LCAV/crazyflie-audio/doc/spectrum_warping.JPG

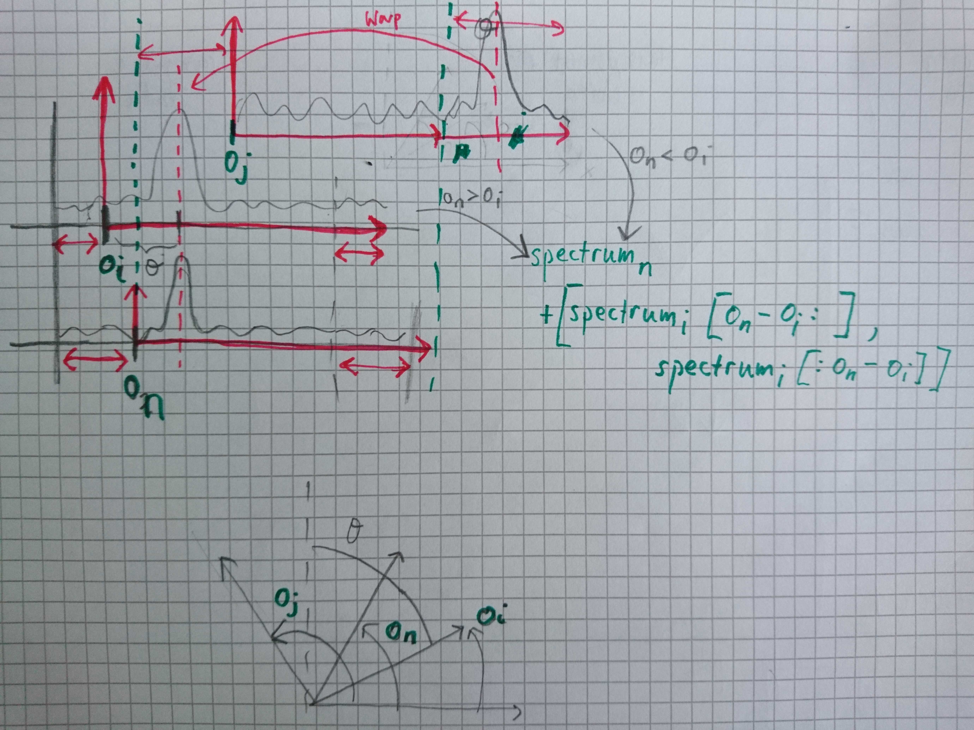
doc/spectrum_warping.JPG
