LCAV/crazyflie-audio/doc/PID tuning the crazyflie.pdf

## PID tuning the crazyflie

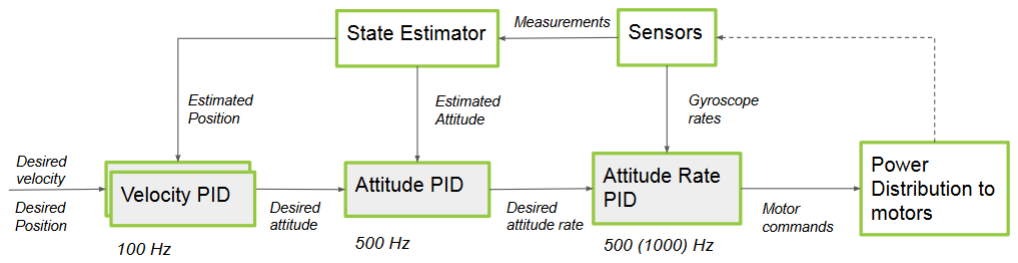
[picture p2: figure]

### Preliminary steps

static trigger_t sitAwFFAccWZ;

static trigger_t sitAwARAccZ;

static trigger_t sitAwTuAcc;

should be commented to avoid compilation errors.

static RPYType stabilizationModeRoll = ANGLE; static RPYType stabilizationModePitch = ANGLE;

should become

static RPYType stabilizationModeRoll = RATE; static RPYType stabilizationModePitch = RATE;

Once all of this is done the modified firmware is uploaded to the crazyflie.

Then we connect to the crazyflie using the client. In the “parameter” tab we can access and change directly the PID gains. Parameter names are pid_rate and pid_attitude. A gaming controller is used to control the crazyflie.

### Tuning the rate PID

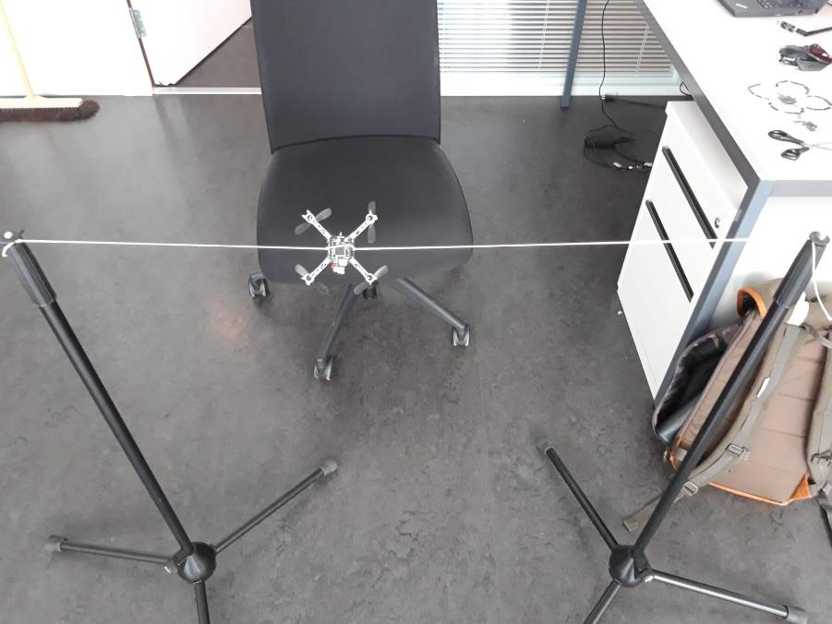
[picture p3: figure]

### Tuning the attitude PID

### Final step
