LCAV/crazyflie-audio/doc/pwm_tuning_control.xlsx

index | Target | Expected error | Measured frequency | Actual error
0 | 3000 | 0 | 3003 | 3
1 | 3125 | 0 | 3133.8 | 8.8
2 | 3250 | 45 | 3260.3 | 10.3
3 | 3375 | 36 | 3381 | 6
4 | 3500 | 0 | 3510.2 | 10.2
5 | 3625 | 18 | 3637.6 | 12.6
6 | 3750 | 0 | 3762.7 | 12.7
7 | 3875 | 19 | 3885.6 | 10.6
8 | 4000 | 0 | 4012.7 | 12.7
9 | 4125 | 31 | 4137.8 | 12.8
10 | 4250 | 36 | 4257.7 | 7.7
11 | 4375 | 0 | 4388.8 | 13.8
12 | 4500 | 36 | 4510.4 | 10.4
13 | 4625 | 9 | 4639.4 | 14.4
14 | 4750 | 125 | 4767.1 | 17.1
15 | 4875 | 45 | 4889.8 | 14.8
