LCAV/crazyflie-audio/hardware/audio_shield_prod/generated/audio_shield-B_Cu.pdf

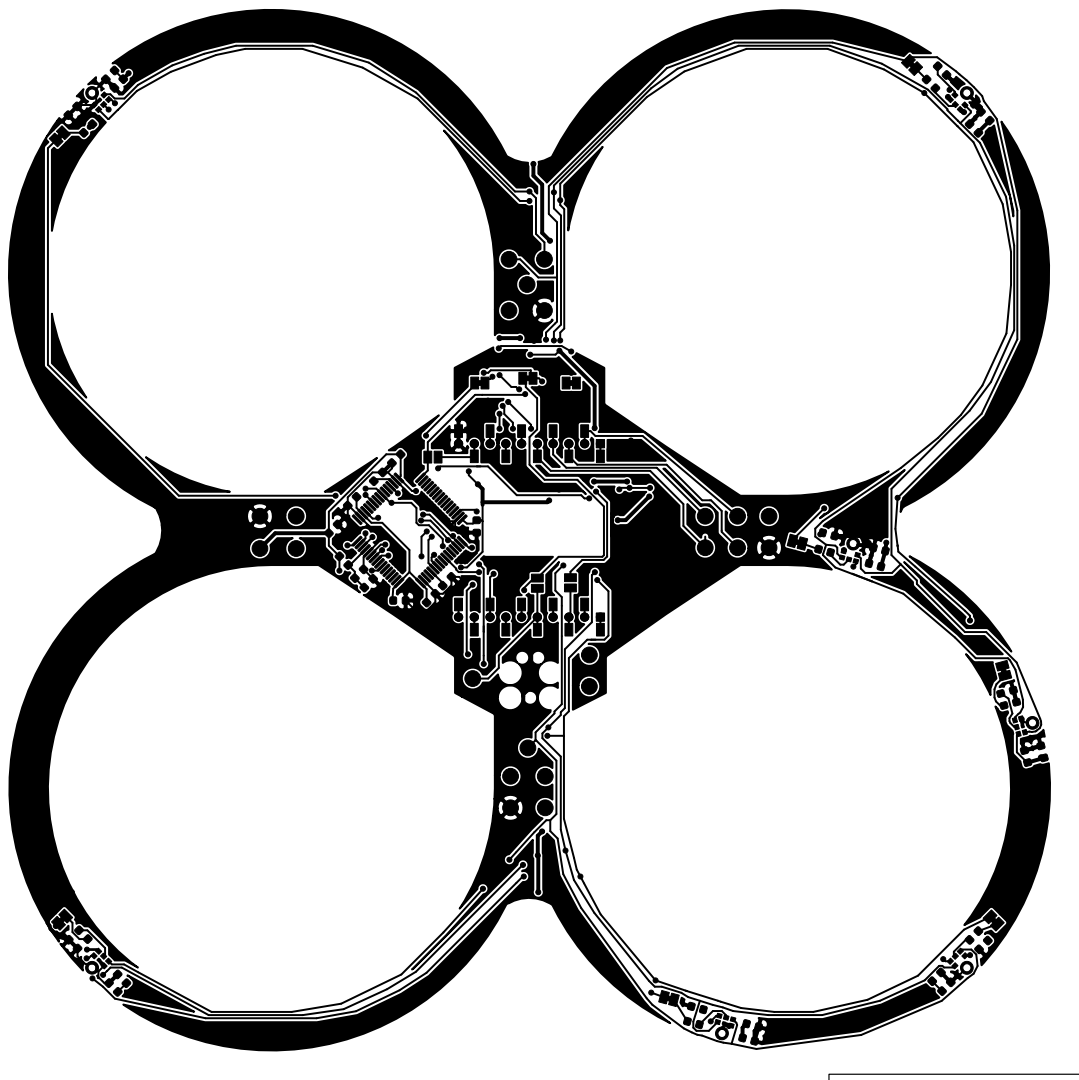
[picture p4: page 1]

Licensed under CC-BY 4.0
File: audio_shield.kicad_pcb Sheet: Bitcraze AB

Id: 1/1 Title: Crazyflie 2.0 expansion template
