LCAV/crazyflie-audio/hardware/audio_shield_V3/audio_shield.kicad_pcb

## KiCad design hardware/audio_shield_V3/audio_shield.kicad_pcb (2021-10-05)

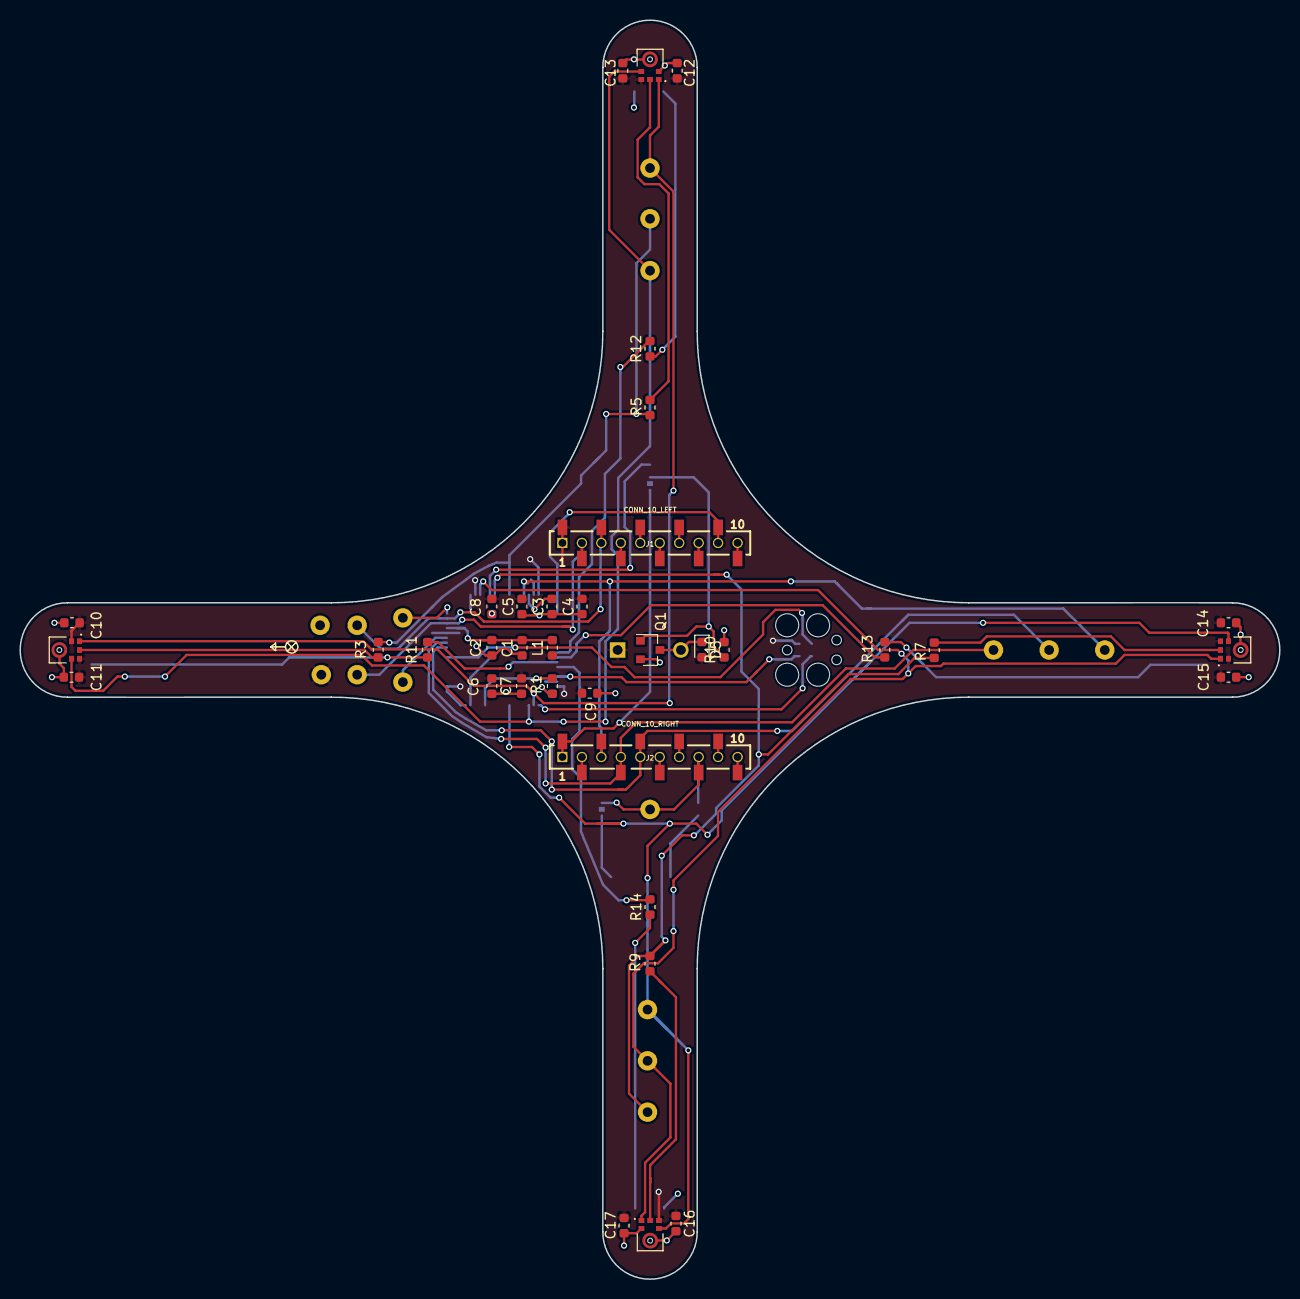
[picture p5: board hardware/audio_shield_V3/audio_shield.kicad_pcb from above]

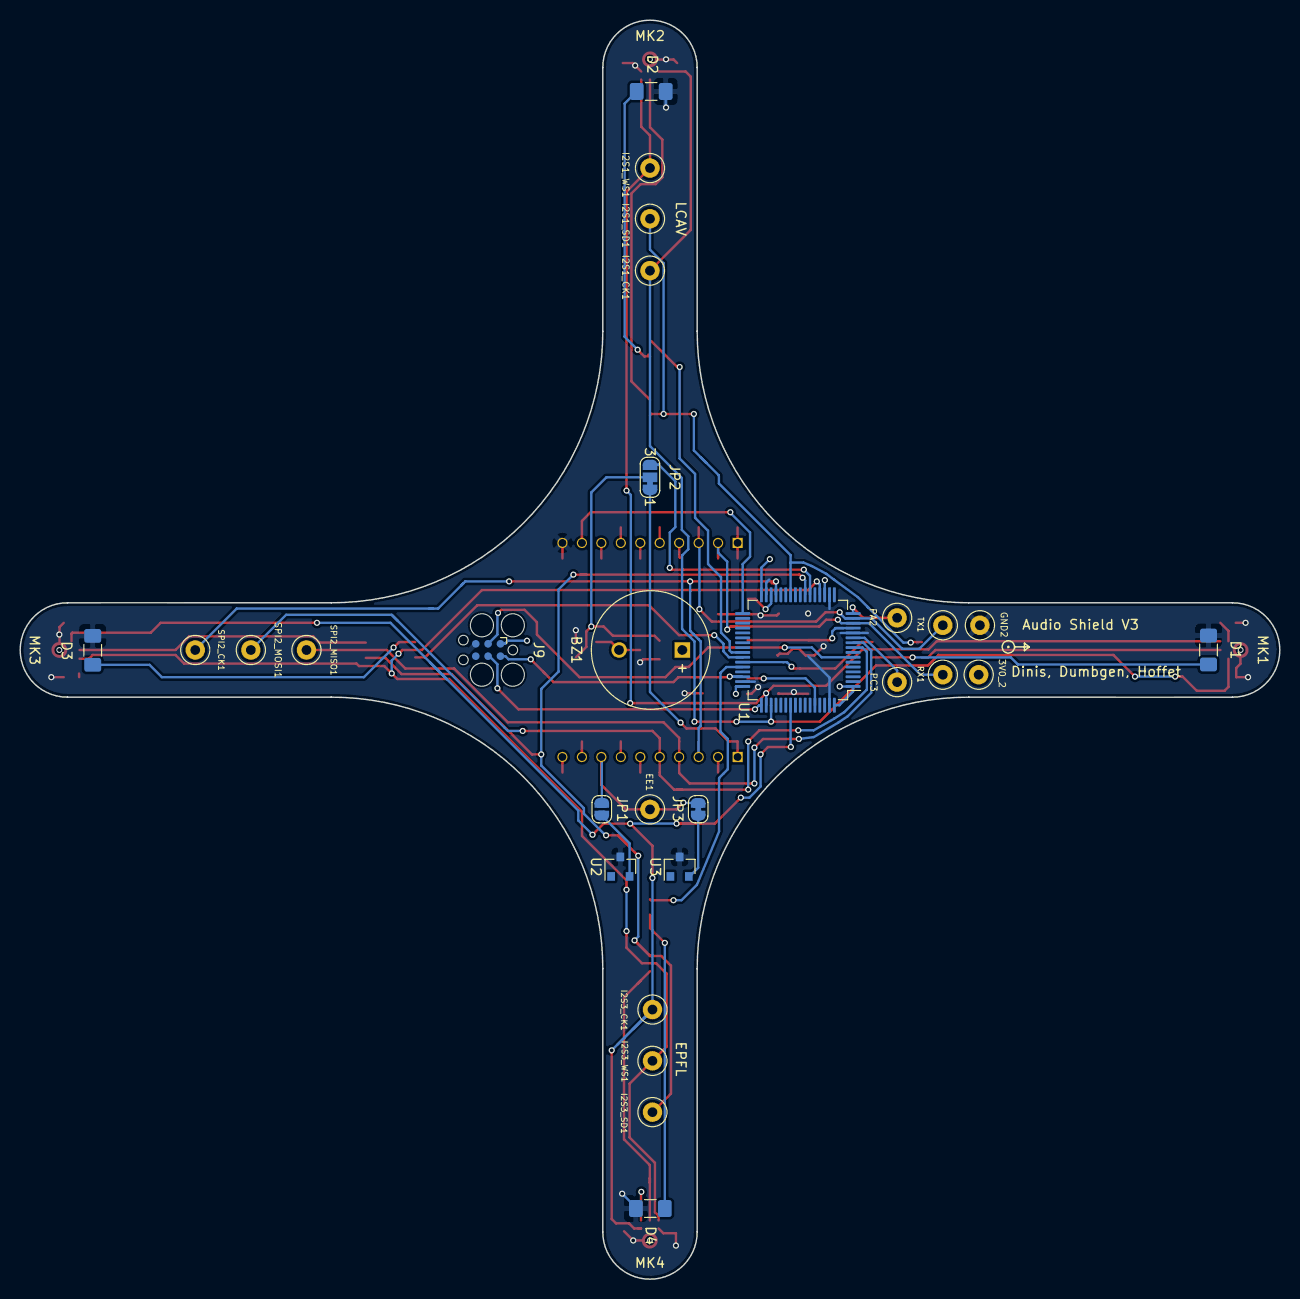
[picture p6: board hardware/audio_shield_V3/audio_shield.kicad_pcb from below]

Board: 2 copper layers, 129.5 x 129.4 mm, 64 parts (28 on the bottom side), 41 nets.

Parts:
3V0_2: TestPoint; TestPoint_Loop_D2.50mm_Drill1.0mm_LowProfile
BZ1: KXG1201B; MagneticBuzzer_ProSignal_ABT-410-RC
C1, C5, C6, C7, C8, C9, C11, C13, C15, C17: 100n; C_0603_1608Metric
C2: 1u; C_0603_1608Metric
C3, C4: 4.7u; C_0603_1608Metric
C10, C12, C14, C16: 220p; C_0603_1608Metric
D1: LED_G; R_1206_3216Metric_Pad1.42x1.75mm_HandSolder
D2, D3, D4: LED_R; R_1206_3216Metric_Pad1.42x1.75mm_HandSolder
D5: DIODE; D_0603_1608Metric
EE1: TestPoint; TestPoint_Loop_D2.50mm_Drill1.0mm_LowProfile
GND2: TestPoint; TestPoint_Loop_D2.50mm_Drill1.0mm_LowProfile
I2S1_CK1, I2S1_SD1, I2S1_WS1, I2S3_CK1, I2S3_SD1, I2S3_WS1: TestPoint; TestPoint_Loop_D2.50mm_Drill1.0mm_LowProfile
J1: CONN_10_LEFT; BF090-10-X-B2
J2: CONN_10_RIGHT; BF090-10-X-B2
J9: SWD_TC2030; Tag-Connect_TC2030-IDC-FP_2x03_P1.27mm_Vertical
JP1: Jumper_2_Open; SolderJumper-2_P1.3mm_Open_RoundedPad1.0x1.5mm
JP2: Jumper_3_Bridged12; SolderJumper-3_P1.3mm_Bridged12_RoundedPad1.0x1.5mm_NumberL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
JP3: Jumper_2_Bridged; SolderJumper-2_P1.3mm_Bridged_RoundedPad1.0x1.5mm
L1: 2.2uH/15mA; L_0603_1608Metric
MK1, MK2, MK3, MK4: SPH0645LM4H-B; MIC_SPH0645LM4H-B
PA2: TestPoint; TestPoint_Loop_D2.50mm_Drill1.0mm_LowProfile
PC3: TestPoint; TestPoint_Loop_D2.50mm_Drill1.0mm_LowProfile
Q1: BS170F; SOT-23
R1, R10: 10k; R_0603_1608Metric
R3, R5, R7, R9, R11, R12, R13, R14: 68; R_0603_1608Metric
RX1: TestPoint; TestPoint_Loop_D2.50mm_Drill1.0mm_LowProfile
SPI2_CK1, SPI2_MISO1, SPI2_MOSI1: TestPoint; TestPoint_Loop_D2.50mm_Drill1.0mm_LowProfile
TX1: TestPoint; TestPoint_Loop_D2.50mm_Drill1.0mm_LowProfile
U1: STM32F446RETx; LQFP-64_10x10mm_P0.5mm
U2, U3: DS2401Z; SOT-23

Connections:
+3V0: 3V0_2.1, BZ1.1, C4.1, C5.1, C6.1, C7.1, C8.1, C9.1, C10.2, C11.2, C12.2, C13.2, C14.2, C15.2, C16.2, C17.2, D5.2, J1.1, J9.1, L1.2, MK1.2, MK1.5, MK2.5, MK3.2, MK3.5, MK4.5, U1.1, U1.19, U1.32, U1.48, U1.64
/AD_Buzzer: JP2.3, U1.22
/CF_Buzzer: J2.1, JP2.1
/EEPROM: EE1.1, J2.8, JP1.1, JP3.1
/I2S1_CK: I2S3_CK1.1, MK3.4, MK4.4, U1.55
/I2S1_SD: I2S3_SD1.1, R7.2, R9.2, U1.23
/I2S1_WS: I2S3_WS1.1, MK3.1, MK4.1, U1.20
/I2S3_CK: I2S1_CK1.1, MK1.4, MK2.4, U1.51
/I2S3_SD: I2S1_SD1.1, R3.2, R5.2, U1.26
/I2S3_WS: I2S1_WS1.1, MK1.1, MK2.1, U1.50
/LED1: R12.2, U1.41
/LED2: R13.2, U1.42
/LED3: R11.2, U1.43
/LED4: R14.2, U1.44
/PA2: PA2.1, U1.16
/PC3: PC3.1, U1.11
/RX1: J1.2, RX1.1, U1.14
/SPI2_CK: J2.3, SPI2_CK1.1, U1.29
/SPI2_MISO: J2.4, SPI2_MISO1.1, U1.10
/SPI2_MOSI: J2.5, SPI2_MOSI1.1, U1.9
/SPI2_NSS: J1.9, U1.33
/SWCLK: J9.4, U1.49
/SWDIO: J9.2, U1.46
/TX1: J1.3, TX1.1, U1.15
/nRESET: J9.3, U1.7
GND: C1.2, C2.2, C3.2, C4.2, C5.2, C6.2, C7.2, C8.2, C9.2, C10.1, C11.1, C12.1, C13.1, C14.1, C15.1, C16.1, C17.1, D1.1, D2.1, D3.1, D4.1, GND2.1, J1.10, J9.5, MK1.3, MK2.2, MK2.3, MK3.3, MK4.2, MK4.3, Q1.2, R1.2, R10.2, U1.12, U1.18, U1.31, U1.47, U1.63, U2.3, U3.3
unnamed: BZ1.2, D5.1, Q1.3
unnamed: C1.1, C2.1, L1.1, U1.13
unnamed: C3.1, U1.30
unnamed: D1.2, R11.1
unnamed: D2.2, R12.1
unnamed: D3.2, R13.1
unnamed: D4.2, R14.1
unnamed: JP1.2, U2.2
unnamed: JP2.2, Q1.1, R10.1
unnamed: JP3.2, U3.2
unnamed: MK1.6, R3.1
unnamed: MK2.6, R5.1
unnamed: MK3.6, R7.1
unnamed: MK4.6, R9.1
unnamed: R1.1, U1.60
