LCAV/crazyflie-audio/hardware/audio_shield_prod/audio_shield.kicad_pcb

## KiCad design hardware/audio_shield_prod/audio_shield.kicad_pcb (2020-10-20)

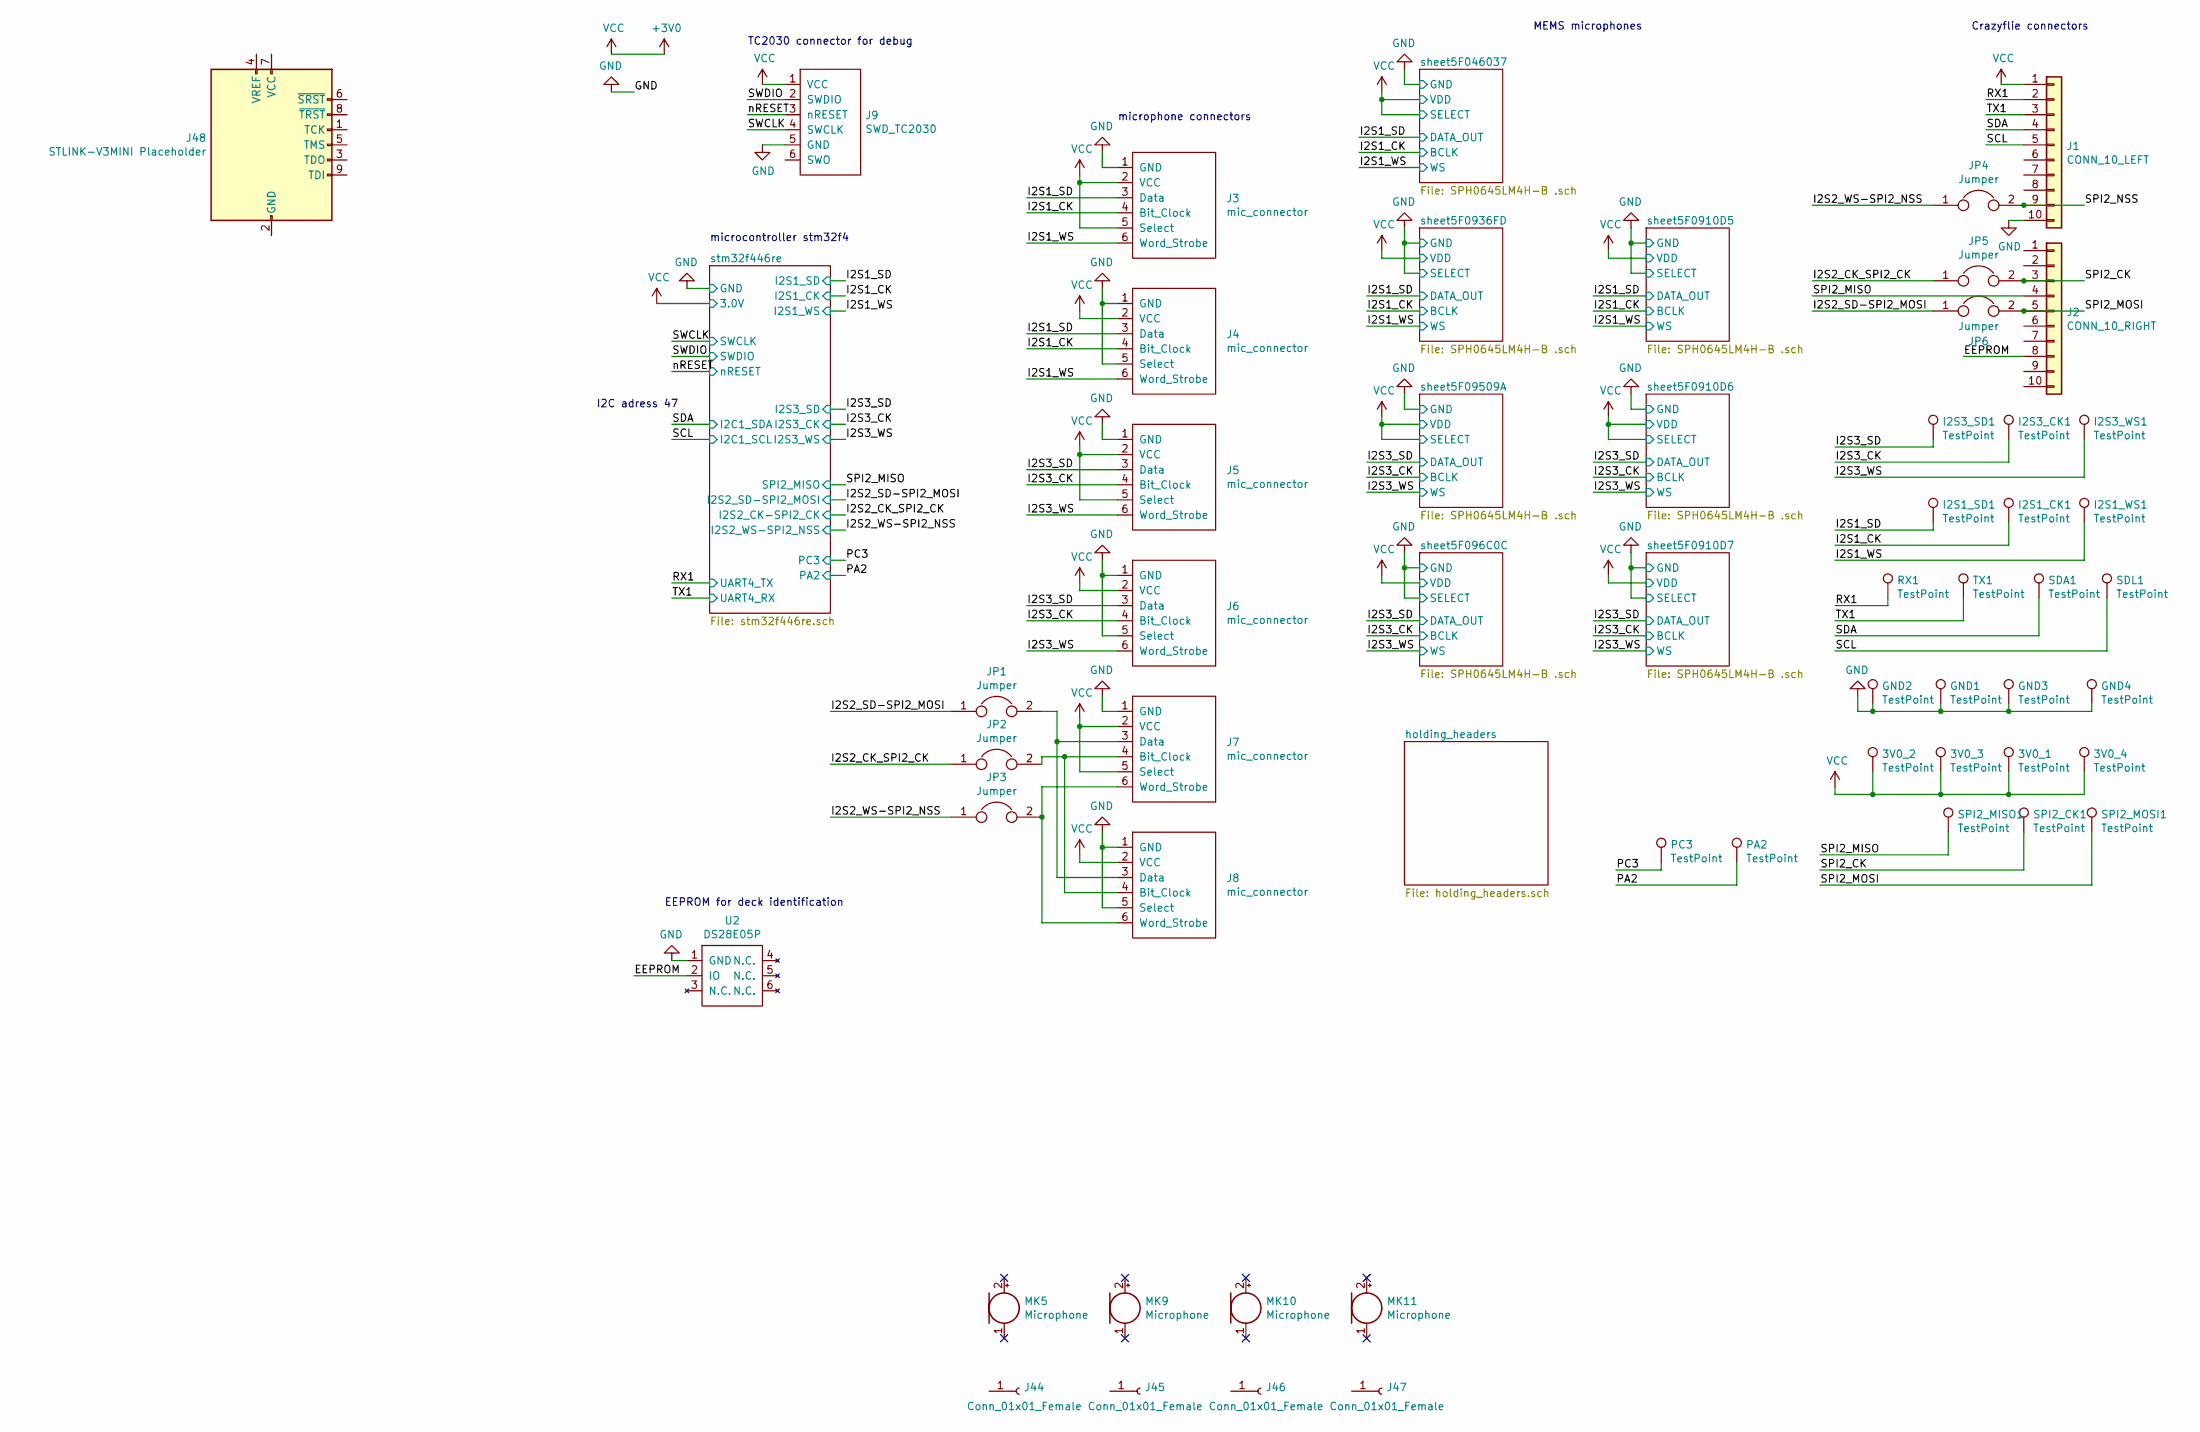
[picture p7: schematic audio_shield.sch]

Parts:
3V0_1, 3V0_2, 3V0_3, 3V0_4: TestPoint; TestPoint_Loop_D2.50mm_Drill1.0mm_LowProfile
GND1, GND2, GND3, GND4: TestPoint; TestPoint_Loop_D2.50mm_Drill1.0mm_LowProfile
I2S1_CK1, I2S1_SD1, I2S1_WS1, I2S3_CK1, I2S3_SD1, I2S3_WS1: TestPoint; TestPoint_Loop_D2.50mm_Drill1.0mm_LowProfile
J1: CONN_10_LEFT; BF090-10-X-B1
J2: CONN_10_RIGHT; BF090-10-X-B1
J3, J4, J5, J6, J7, J8: mic_connector; 6288_series_8_pos
J9: SWD_TC2030; Tag-Connect_TC2030-IDC-FP_2x03_P1.27mm_Vertical
J44, J45, J46, J47: Conn_01x01_Female
J48: STLINK-V3MINI Placeholder
JP1, JP2, JP3: Jumper; SolderJumper-2_P1.3mm_Bridged_Pad1.0x1.5mm
JP4, JP5, JP6: Jumper; SolderJumper-2_P1.3mm_Open_Pad1.0x1.5mm
MK5, MK9, MK10, MK11: Microphone
PA2: TestPoint; TestPoint_Loop_D2.50mm_Drill1.0mm_LowProfile
PC3: TestPoint; TestPoint_Loop_D2.50mm_Drill1.0mm_LowProfile
RX1: TestPoint; TestPoint_Loop_D2.50mm_Drill1.0mm_LowProfile
SDA1: TestPoint; TestPoint_Loop_D2.50mm_Drill1.0mm_LowProfile
SDL1: TestPoint; TestPoint_Loop_D2.50mm_Drill1.0mm_LowProfile
SPI2_CK1, SPI2_MISO1, SPI2_MOSI1: TestPoint; TestPoint_Loop_D2.50mm_Drill1.0mm_LowProfile
TX1: TestPoint; TestPoint_Loop_D2.50mm_Drill1.0mm_LowProfile
U2: DS28E05P; TSOC-6_3.76x3.94mm_P1.27mm

Connections:
+3V0: 3V0_1.1, 3V0_2.1, 3V0_3.1, 3V0_4.1, J1.1, J3.2 (VCC), J3.5 (Select), J4.2 (VCC), J5.2 (VCC), J5.5 (Select), J6.2 (VCC), J7.2 (VCC), J7.5 (Select), J8.2 (VCC), J9.1 (VCC); also elsewhere on the board
/EEPROM: J2.8, U2.2 (IO)
/I2S1_CK: I2S1_CK1.1, J3.4 (Bit_Clock), J4.4 (Bit_Clock); also elsewhere on the board
/I2S1_SD: I2S1_SD1.1, J3.3 (Data), J4.3 (Data); also elsewhere on the board
/I2S1_WS: I2S1_WS1.1, J3.6 (Word_Strobe), J4.6 (Word_Strobe); also elsewhere on the board
/I2S2_CK_SPI2_CK: JP2.1, JP5.1; also elsewhere on the board
/I2S2_SD-SPI2_MOSI: JP1.1, JP6.1; also elsewhere on the board
/I2S2_WS-SPI2_NSS: JP3.1, JP4.1; also elsewhere on the board
/I2S3_CK: I2S3_CK1.1, J5.4 (Bit_Clock), J6.4 (Bit_Clock); also elsewhere on the board
/I2S3_SD: I2S3_SD1.1, J5.3 (Data), J6.3 (Data); also elsewhere on the board
/I2S3_WS: I2S3_WS1.1, J5.6 (Word_Strobe), J6.6 (Word_Strobe); also elsewhere on the board
/PA2: PA2.1; also elsewhere on the board
/PC3: PC3.1; also elsewhere on the board
/RX1: J1.2, RX1.1; also elsewhere on the board
/SCL: J1.5, SDL1.1; also elsewhere on the board
/SDA: J1.4, SDA1.1; also elsewhere on the board
/SPI2_CK: J2.3, JP5.2, SPI2_CK1.1
/SPI2_MISO: J2.4, SPI2_MISO1.1; also elsewhere on the board
/SPI2_MOSI: J2.5, JP6.2, SPI2_MOSI1.1
/SPI2_NSS: J1.9, JP4.2
/SWCLK: J9.4 (SWCLK); also elsewhere on the board
/SWDIO: J9.2 (SWDIO); also elsewhere on the board
/TX1: J1.3, TX1.1; also elsewhere on the board
/nRESET: J9.3 (nRESET); also elsewhere on the board
GND: GND1.1, GND2.1, GND3.1, GND4.1, J1.10, J3.1 (GND), J4.1 (GND), J4.5 (Select), J5.1 (GND), J6.1 (GND), J6.5 (Select), J7.1 (GND), J8.1 (GND), J8.5 (Select), J9.5 (GND), U2.1 (GND); also elsewhere on the board
unnamed: J7.3 (Data), J8.3 (Data), JP1.2
unnamed: J7.4 (Bit_Clock), J8.4 (Bit_Clock), JP2.2
unnamed: J7.6 (Word_Strobe), J8.6 (Word_Strobe), JP3.2
unnamed: J48.2 (GND), J48.10 (GND)

Notes on the sheet:
microcontroller stm32f4
microphone connectors
TC2030 connector for debug
MEMS microphones
Crazyflie connectors
EEPROM for deck identification
I2C adress 47

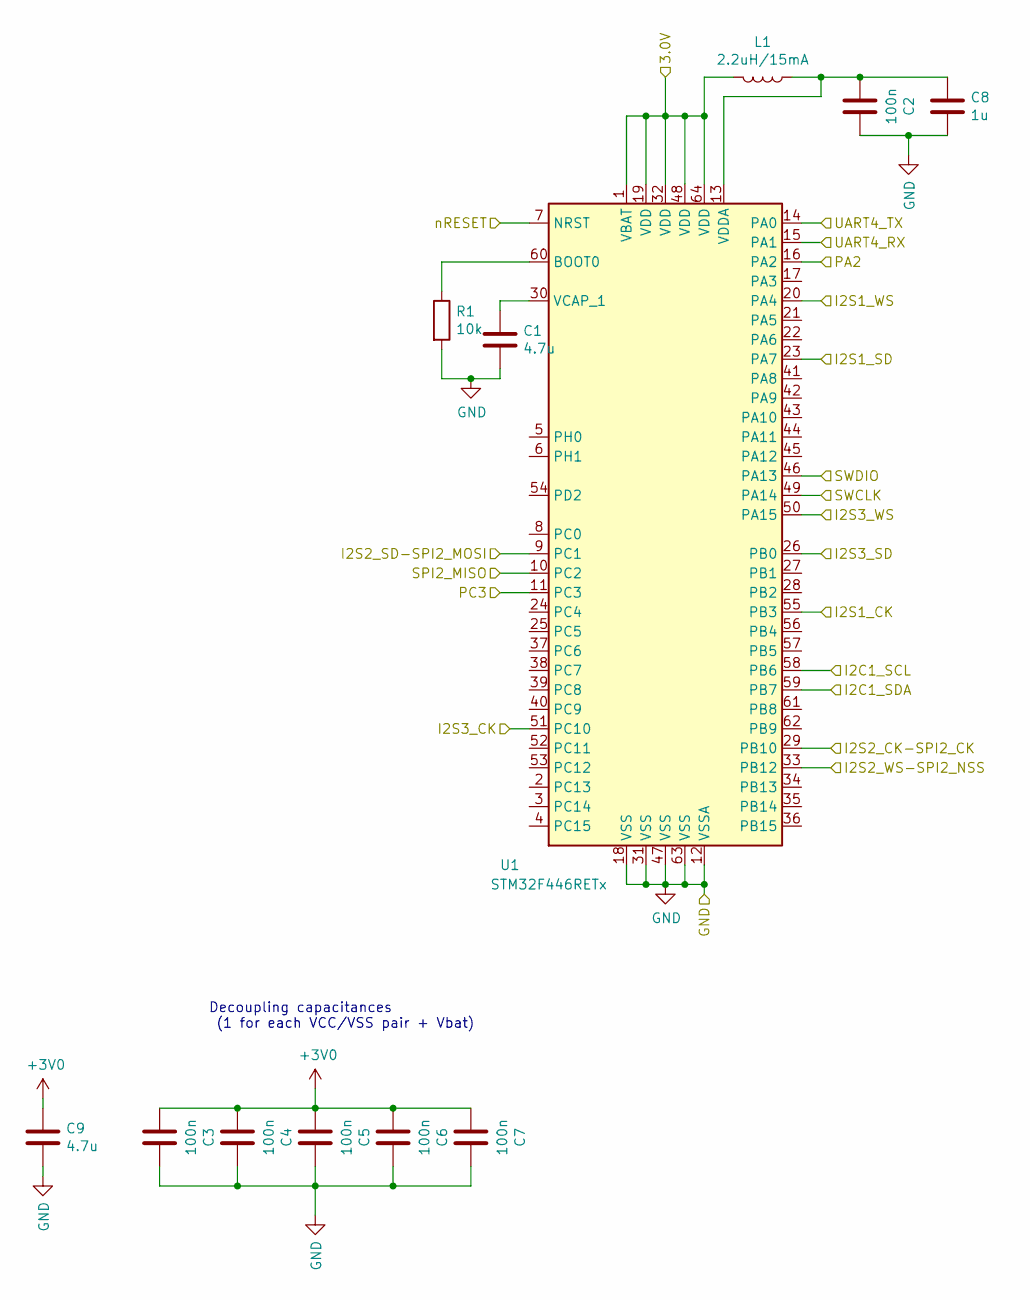
[picture p8: schematic stm32f446re.sch]

Parts:
C1, C9: 4.7u; C_0603_1608Metric
C2, C3, C4, C5, C6, C7: 100n; C_0603_1608Metric
C8: 1u; C_0603_1608Metric
L1: 2.2uH/15mA; L_0603_1608Metric
R1: 10k; R_0603_1608Metric
U1: STM32F446RETx; LQFP-64_10x10mm_P0.5mm

Connections:
+3V0: C3.1, C4.1, C5.1, C6.1, C7.1, C9.1, L1.2, U1.1 (VBAT), U1.19 (VDD), U1.32 (VDD), U1.48 (VDD), U1.64 (VDD); also elsewhere on the board
/I2S1_CK: U1.55 (PB3); also elsewhere on the board
/I2S1_SD: U1.23 (PA7); also elsewhere on the board
/I2S1_WS: U1.20 (PA4); also elsewhere on the board
/I2S2_CK_SPI2_CK: U1.29 (PB10); also elsewhere on the board
/I2S2_SD-SPI2_MOSI: U1.9 (PC1); also elsewhere on the board
/I2S2_WS-SPI2_NSS: U1.33 (PB12); also elsewhere on the board
/I2S3_CK: U1.51 (PC10); also elsewhere on the board
/I2S3_SD: U1.26 (PB0); also elsewhere on the board
/I2S3_WS: U1.50 (PA15); also elsewhere on the board
/PA2: U1.16 (PA2); also elsewhere on the board
/PC3: U1.11 (PC3); also elsewhere on the board
/RX1: U1.14 (PA0); also elsewhere on the board
/SCL: U1.58 (PB6); also elsewhere on the board
/SDA: U1.59 (PB7); also elsewhere on the board
/SPI2_MISO: U1.10 (PC2); also elsewhere on the board
/SWCLK: U1.49 (PA14); also elsewhere on the board
/SWDIO: U1.46 (PA13); also elsewhere on the board
/TX1: U1.15 (PA1); also elsewhere on the board
/nRESET: U1.7 (NRST); also elsewhere on the board
GND: C1.2, C2.2, C3.2, C4.2, C5.2, C6.2, C7.2, C8.2, C9.2, R1.2, U1.12 (VSSA), U1.18 (VSS), U1.31 (VSS), U1.47 (VSS), U1.63 (VSS); also elsewhere on the board
unnamed: C1.1, U1.30 (VCAP_1)
unnamed: C2.1, C8.1, L1.1, U1.13 (VDDA)
unnamed: R1.1, U1.60 (BOOT0)

Notes on the sheet:
Decoupling capacitances (1 for each VCC/VSS pair + Vbat)

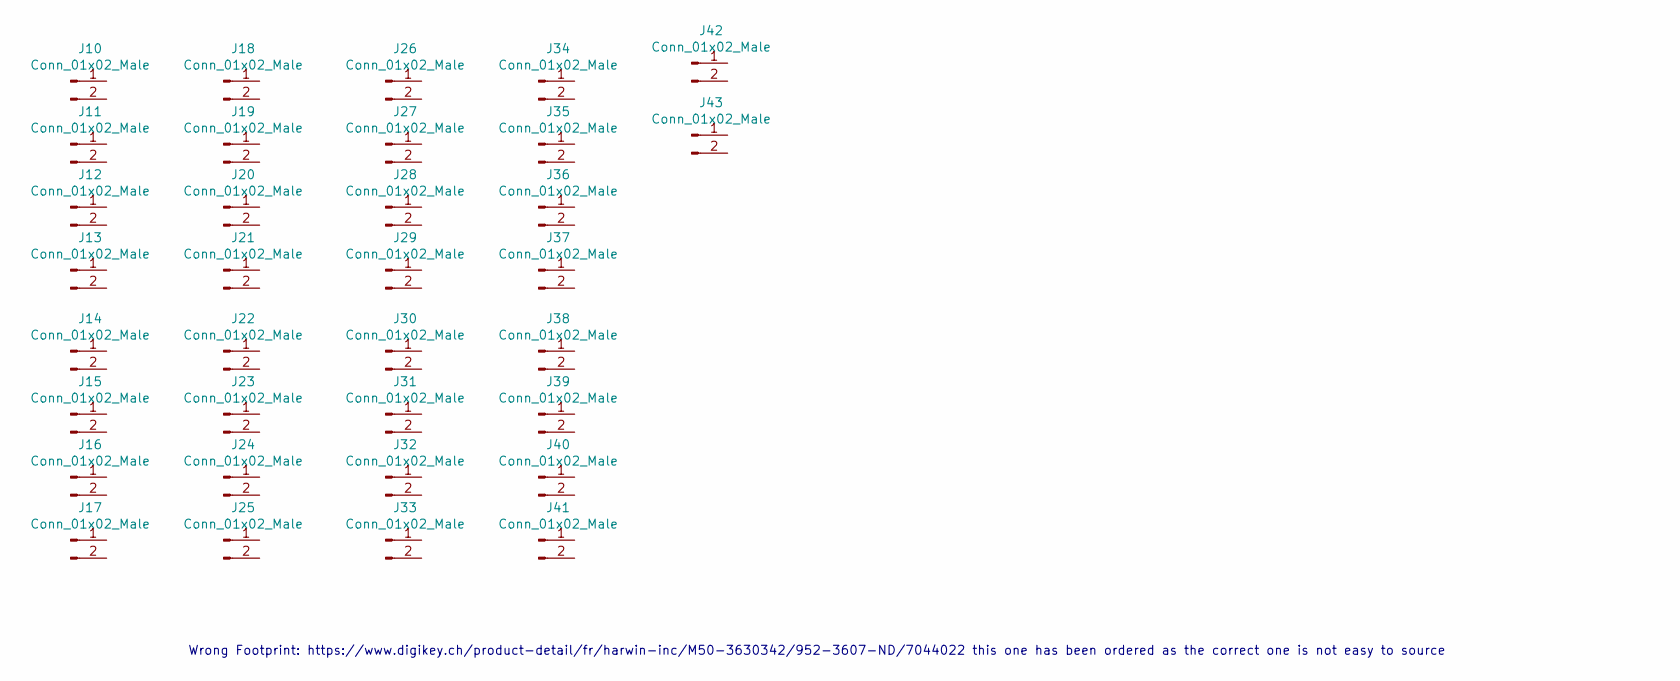
[picture p9: schematic holding_headers.sch]

Parts:
J10, J11, J12, J13, J14, J15, J16, J17, J18, J19, J20, J21, J22, J23, J24, J25, J26, J27, J28, J29, J30, J31, J32, J33, J34, J35, J36, J37, J38, J39, J40, J41, J42, J43: Conn_01x02_Male; PinHeader_1x02_P1.00mm_Vertical_SMD_Pin1Left

Notes on the sheet:
Wrong Footprint: https://www.digikey.ch/product-detail/fr/harwin-inc/M50-3630342/952-3607-ND/7044022 this one has been ordered as the correct one is not easy to source

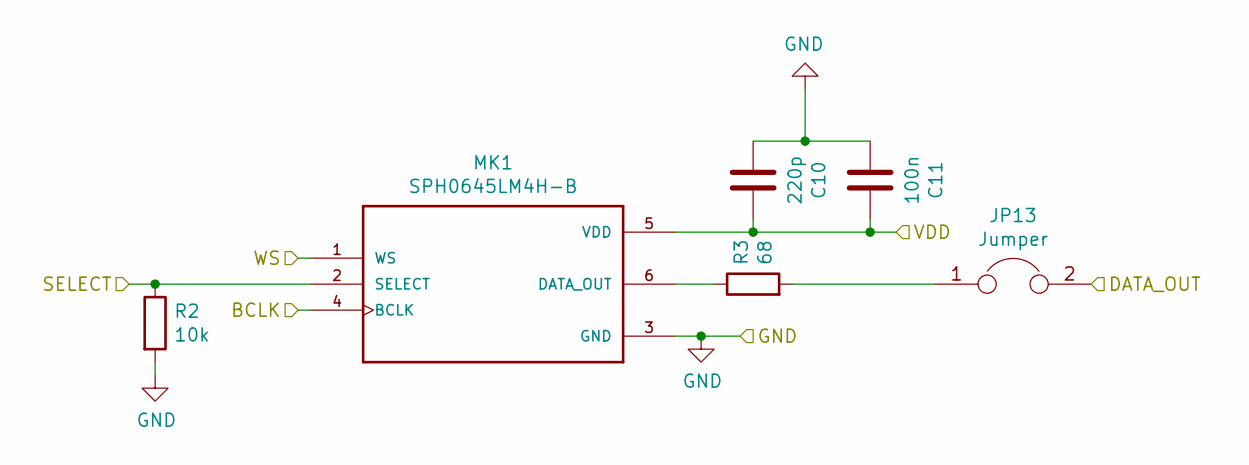
[picture p10: schematic SPH0645LM4H-B .sch]

Parts:
C10: 100n; C_0603_1608Metric
C11: 220p; C_0603_1608Metric
JP12: Jumper; SolderJumper-2_P1.3mm_Bridged_Pad1.0x1.5mm
MK1: SPH0645LM4H-B; MIC_SPH0645LM4H-B
R2: 10k; R_0603_1608Metric
R3: 68; R_0603_1608Metric

Connections:
+3V0: C10.2, C11.2, MK1.2 (SELECT), MK1.5 (VDD), R2.1; also elsewhere on the board
/I2S1_CK: MK1.4 (BCLK); also elsewhere on the board
/I2S1_SD: JP12.2; also elsewhere on the board
/I2S1_WS: MK1.1 (WS); also elsewhere on the board
GND: C10.1, C11.1, MK1.3 (GND), R2.2; also elsewhere on the board
unnamed: MK1.6 (DATA_OUT), R3.1

Parts of its further copies:
C12, C14, C16, C18, C20, C22, C24: 220p; C_0603_1608Metric
C13, C15, C17, C19, C21, C23, C25: 100n; C_0603_1608Metric
JP7, JP8, JP9, JP10, JP11, JP13: Jumper; SolderJumper-2_P1.3mm_Bridged_Pad1.0x1.5mm
MK2, MK3, MK4, MK6, MK7, MK8: SPH0645LM4H-B; MIC_SPH0645LM4H-B
R4, R6, R8, R10, R12, R14, R16: 10k; R_0603_1608Metric
R5, R7, R9, R11, R13, R15, R17: 68; R_0603_1608Metric

Connections of its further copies:
+3V0: C12.2, C13.2, C14.2, C15.2, C16.2, C17.2, C20.2, C21.2, C22.2, C23.2, C24.2, C25.2, MK2.5 (VDD), MK3.2 (SELECT), MK3.5 (VDD), MK4.5 (VDD), MK6.5 (VDD), MK7.2 (SELECT), MK7.5 (VDD), MK8.5 (VDD), R6.1, R14.1; also elsewhere on the board
/I2S1_CK: MK2.4 (BCLK), MK6.4 (BCLK); also elsewhere on the board
/I2S1_SD: JP7.2, JP13.2; also elsewhere on the board
/I2S1_WS: MK2.1 (WS), MK6.1 (WS); also elsewhere on the board
/I2S3_CK: MK3.4 (BCLK), MK4.4 (BCLK), MK7.4 (BCLK), MK8.4 (BCLK); also elsewhere on the board
/I2S3_SD: JP8.2, JP9.2, JP10.2, JP11.2; also elsewhere on the board
/I2S3_WS: MK3.1 (WS), MK4.1 (WS), MK7.1 (WS), MK8.1 (WS); also elsewhere on the board
GND: C12.1, C13.1, C14.1, C15.1, C16.1, C17.1, C20.1, C21.1, C22.1, C23.1, C24.1, C25.1, MK2.2 (SELECT), MK2.3 (GND), MK3.3 (GND), MK4.2 (SELECT), MK4.3 (GND), MK6.2 (SELECT), MK6.3 (GND), MK7.3 (GND), MK8.2 (SELECT), MK8.3 (GND), R4.1, R4.2, R6.2, R8.1, R8.2, R12.1, R12.2, R14.2, R16.1, R16.2; also elsewhere on the board
unnamed: JP7.1, R13.2
unnamed: JP8.1, R15.2
unnamed: JP9.1, R17.2
unnamed: JP10.1, R9.2
unnamed: JP11.1, R7.2
unnamed: MK2.6 (DATA_OUT), R5.1
unnamed: MK3.6 (DATA_OUT), R7.1
unnamed: MK4.6 (DATA_OUT), R9.1
unnamed: MK6.6 (DATA_OUT), R13.1
unnamed: MK7.6 (DATA_OUT), R15.1
unnamed: MK8.6 (DATA_OUT), R17.1

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
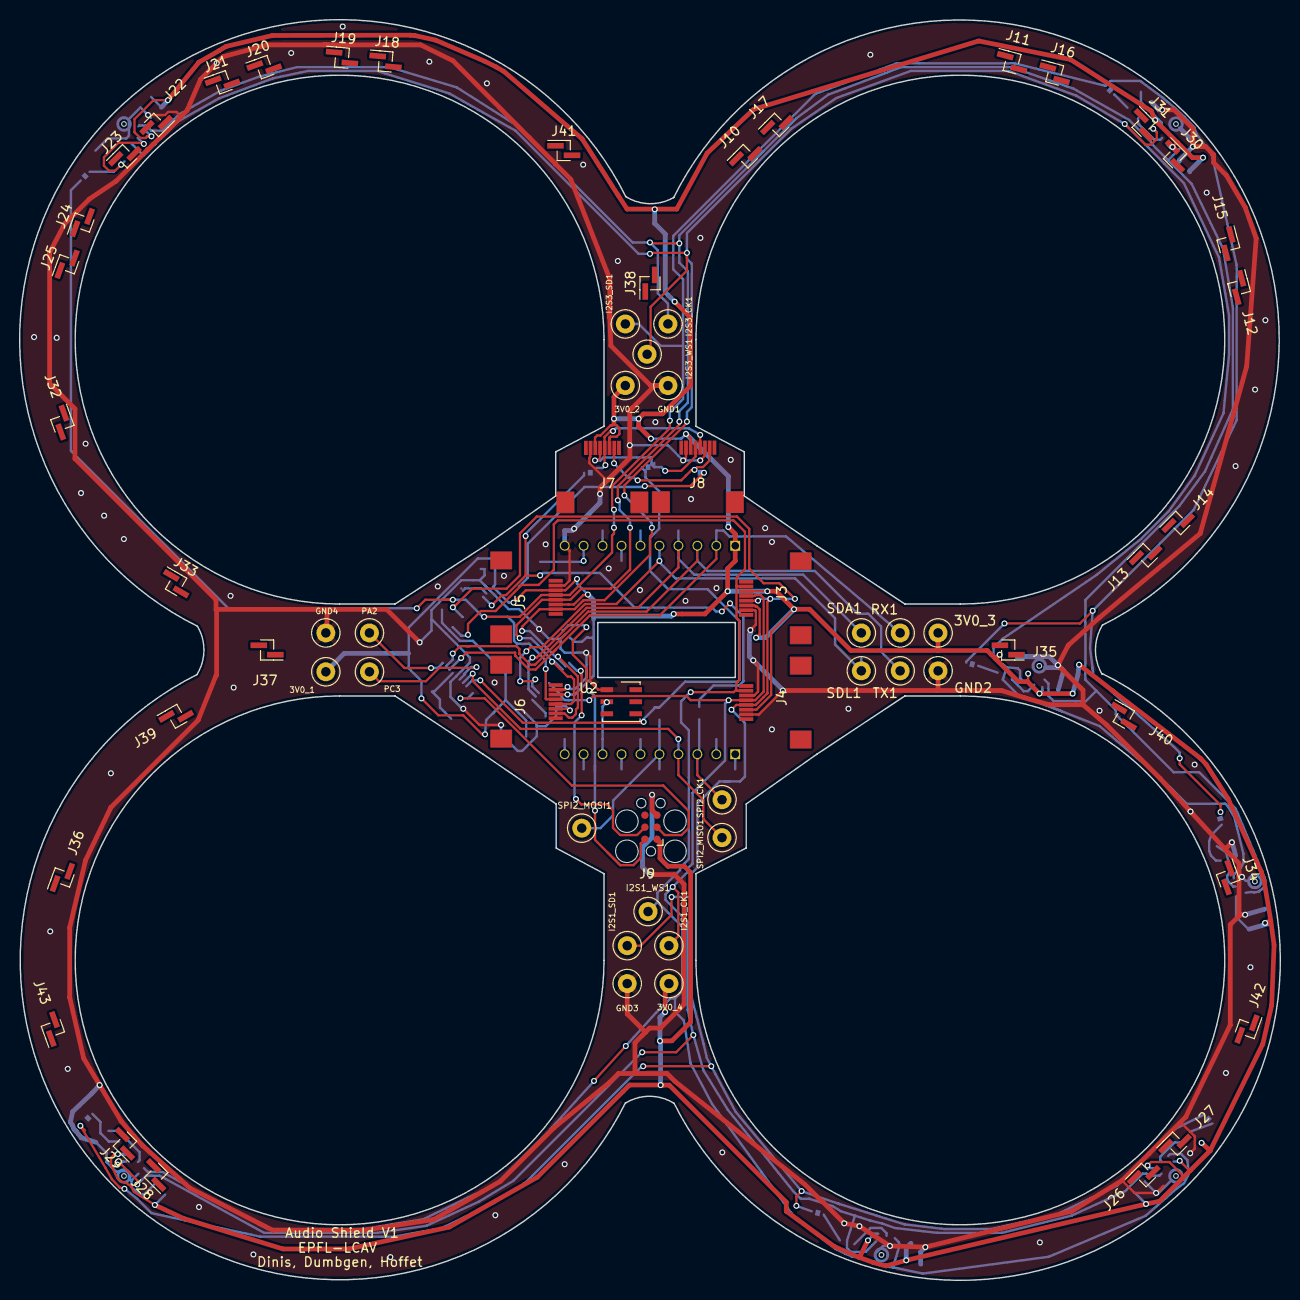
[picture p11: board hardware/audio_shield_prod/audio_shield.kicad_pcb from above]

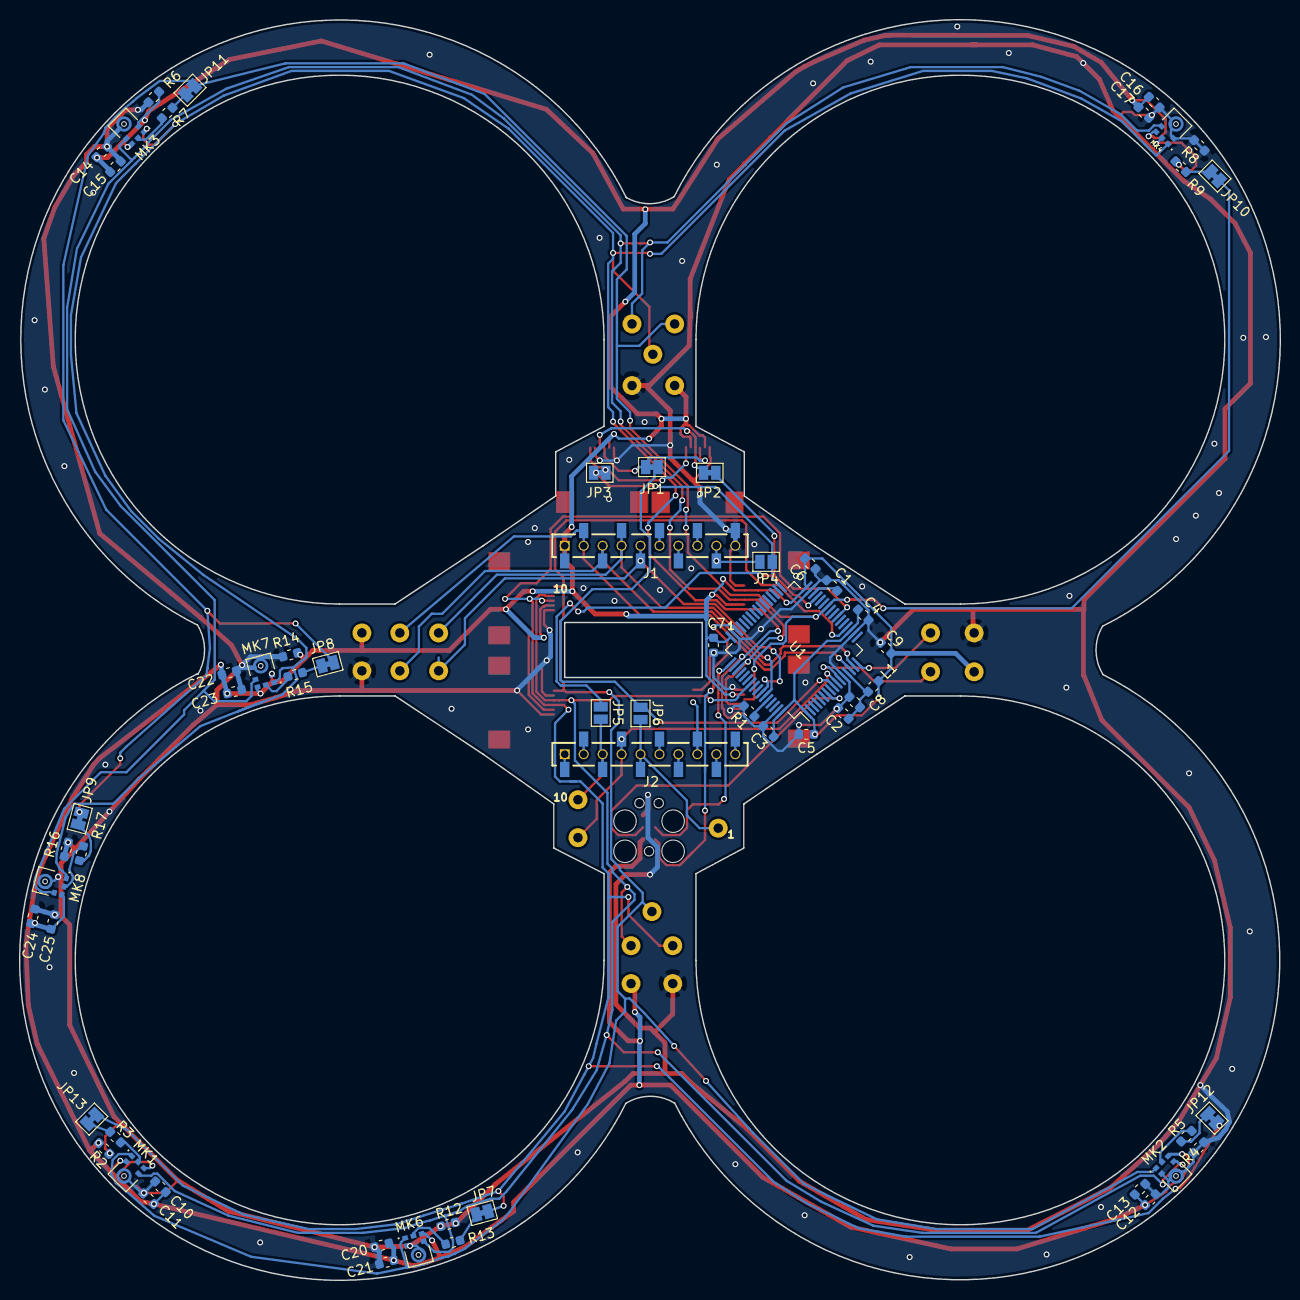
[picture p12: board hardware/audio_shield_prod/audio_shield.kicad_pcb from below]

Board: 2 copper layers, 133.0 x 133.0 mm, 127 parts (62 on the bottom side), 45 nets.
