LCAV/crazyflie-audio/firmware/audio_shield_firmware/audio_shield_firmware.ioc

Mcu.UserName=STM32F446RETx
PA10.GPIO_Label=LD3_TIM1_CH3
PA10.Signal=S_TIM1_CH3
PA11.GPIO_Label=LD4_TIM1_CH4
PA11.Signal=S_TIM1_CH4
PA13.GPIO_Label=TMS
PA13.Signal=SYS_JTMS-SWDIO
PA14.GPIO_Label=TCK
PA14.Signal=SYS_JTCK-SWCLK
PA15.Signal=I2S3_WS
PA2.Signal=S_TIM5_CH3
PA3.Signal=S_TIM5_CH4
PA4.Signal=I2S1_WS
PA6.GPIO_Label=Buzzer_TIM3_CH1
PA6.Signal=S_TIM3_CH1
PA7.Signal=I2S1_SD
PA8.GPIO_Label=LD1_TIM1_CH1
PA8.Signal=S_TIM1_CH1
PA9.GPIO_Label=LD2_TIM1_CH2
PA9.Signal=S_TIM1_CH2
PB0.Signal=I2S3_SD
PB10.Signal=SPI2_SCK
PB12.Signal=SPI2_NSS
PB3.Signal=I2S1_CK
PC1.Signal=SPI2_MOSI
PC10.Signal=I2S3_CK
PC14-OSC32_IN.Signal=RCC_OSC32_IN
PC15-OSC32_OUT.Signal=RCC_OSC32_OUT
PC2.Signal=SPI2_MISO
PC3.GPIO_Label=PC3
PC3.Signal=GPIO_Output
PH0-OSC_IN.Signal=RCC_OSC_IN
PH1-OSC_OUT.Signal=RCC_OSC_OUT
