LCAV/crazyflie-audio/firmware/audio_shield_firmware/Core/Inc/main.h

#define PC3_Pin GPIO_PIN_3
#define PC3_GPIO_Port GPIOC
#define Buzzer_TIM3_CH1_Pin GPIO_PIN_6
#define Buzzer_TIM3_CH1_GPIO_Port GPIOA
#define LD1_TIM1_CH1_Pin GPIO_PIN_8
#define LD1_TIM1_CH1_GPIO_Port GPIOA
#define LD2_TIM1_CH2_Pin GPIO_PIN_9
#define LD2_TIM1_CH2_GPIO_Port GPIOA
#define LD3_TIM1_CH3_Pin GPIO_PIN_10
#define LD3_TIM1_CH3_GPIO_Port GPIOA
#define LD4_TIM1_CH4_Pin GPIO_PIN_11
#define LD4_TIM1_CH4_GPIO_Port GPIOA
#define TMS_Pin GPIO_PIN_13
#define TMS_GPIO_Port GPIOA
#define TCK_Pin GPIO_PIN_14
#define TCK_GPIO_Port GPIOA
