LCAV/crazyflie-audio/python/serial_motors.py

#! /usr/bin/env python3
# -*- coding: utf-8 -*-

"""
serial_motors.py: Class to control serial motors (linear and rotational)
"""

import serial
import time

# Ubuntu:
# to find serial port, run python -m serial.tools.list_ports
SERIAL_PORT = "/dev/ttyACM0"

# duration for longest movements (in seconds)
DURATION_50 = 165
DURATION_360 = 27

# (distance (cm), command, time (s))
move = {
    "forward": [
        (0.1, b"q", 2.0),
        (1, b"w", 5.0),
        (5, b"e", 15.0),
        (30, b"r", DURATION_50),
    ],
    "backward": [
        (0.1, b"a", 2.0),
        (1, b"s", 5.0),
        (5, b"d", 15.0),
        (30, b"f", DURATION_50),
    ],
}

turn = {
    "forward": [(5, b"u", 2), (30, b"p", 3), (90, b"o", 8), (360, b"i", DURATION_360)],
    "backward": [(5, b"h", 2), (30, b"l", 3), (90, b"k", 8), (360, b"j", DURATION_360)],
}


class SerialMotors(object):
    def __init__(
        self,
        port=SERIAL_PORT,
        baudrate=115200,
        verbose=False,
        current_angle=0,
        current_distance=0,
    ):
        self.port = SERIAL_PORT
        self.serial = serial.Serial(port, baudrate)
        self.verbose = verbose

        self.current_angle = current_angle
        self.current_distance = current_distance

    def turn(self, angle_deg, blocking=True):
        if angle_deg > 0:
            self.turn_forward(angle_deg, blocking)
        elif angle_deg < 0:
            self.turn_back(-angle_deg, blocking)

    def turn_to(self, angle_deg, blocking=True):
        delta = angle_deg - self.current_angle
        self.turn(delta, blocking)

    def turn_forward(self, angle_deg, blocking=True):
        self.move_in_chunks(turn["forward"], angle_deg, blocking=blocking)
        self.current_angle += angle_deg

    def turn_back(self, angle_deg, blocking=True):
        self.move_in_chunks(turn["backward"], angle_deg, blocking=blocking)
        self.current_angle -= angle_deg

    def move(self, delta_cm, blocking=True):
        if delta_cm > 0:
            self.move_forward(delta_cm, blocking)
        elif delta_cm < 0:
            self.move_back(-delta_cm, blocking)

    def move_to(self, distance_cm, blocking=True):
        delta = distance_cm - self.current_distance
        self.move(delta, blocking)

    def move_forward(self, delta_cm, blocking=True):
        self.move_in_chunks(move["forward"], delta_cm, blocking=blocking)
        self.current_distance += delta_cm

    def move_back(self, delta_cm, blocking=True):
        self.move_in_chunks(move["backward"], delta_cm, blocking=blocking)
        self.current_distance -= delta_cm

    def move_in_chunks(self, commands, total, blocking=True):
        assert total >= 0
        leftover = total
        commands_decreasing = sorted(commands, key=lambda tuple_: tuple_[0])[::-1]
        for partial, command, time_s in commands_decreasing:
            num_commands = int(leftover // partial)

            if self.verbose:
                print(f"moving {leftover} in chunks of {partial}")

            if (num_commands > 1) and not blocking:
                if self.verbose:
                    print(f"cannot move by {leftover} in non-blocking mode.")
                blocking = True

            for i in range(num_commands):
                if self.verbose:
                    print(f"running command {i+1}/{num_commands}")
                self.serial.write(command)

                if blocking:
                    time.sleep(time_s)  # wait for linear movement to be done

            leftover = leftover % partial

        if leftover != 0:
            print(f"Warning: not moving by last {leftover} cm.")


if __name__ == "__main__":
    sm = SerialMotors(verbose=True)
    #sm.move(1.0)
    #sm.move_back(1.0)
    #sm.turn(10)
    #sm.turn_back(10)
