LCAV/crazyflie-audio/firmware/audio_shield_firmware/Core/Inc/real_data_1024.h

float32_t mk2[1024] = {-341.397022332506140, -446.397022332506140, -397.397022332506140, -214.397022332506140, -140.397022332506140, -377.397022332506140, -657.397022332506140, -693.397022332506140, -624.397022332506140, -658.397022332506140, -781.397022332506140, -1021.397022332506140, -1180.397022332506140, -1085.397022332506140, -954.397022332506140, -1019.397022332506140, -1012.397022332506140, -955.397022332506140, -1361.397022332506140, -1785.397022332506140, -1703.397022332506140, -1651.397022332506140, -1810.397022332506140, -1967.397022332506140, -1729.397022332506140, -1248.397022332506140, -1219.397022332506140, -1627.397022332506140, -2042.397022332506140, -2050.397022332505912, -1866.397022332506140, -1669.397022332506140, -1517.397022332506140, -1464.397022332506140, -1519.397022332506140, -1387.397022332506140, -990.397022332506140, -879.397022332506140, -998.397022332506140, -751.397022332506140, -298.397022332506140, -244.397022332506140, -337.397022332506140, -54.397022332506140, 411.602977667493860, 654.602977667493860, 786.602977667493860, 970.602977667493860, 1320.602977667493860, 1364.602977667493860, 1112.602977667493860, 1252.602977667493860, 1596.602977667493860, 1472.602977667493860, 1235.602977667493860, 1309.602977667493860, 1270.602977667493860, 1061.602977667493860, 868.602977667493860, 702.602977667493860, 500.602977667493860, 218.602977667493860, -35.397022332506140, -77.397022332506140, -132.397022332506140, -108.397022332506140, -54.397022332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
