LCAV/crazyflie-audio/firmware/audio_shield_firmware/Core/Inc/flattop_window.h

#ifndef __FLATTOP_WINDOW_H 
#define __FLATTOP_WINDOW_H

int16_t flattop_window[1024] = {-14, -14, -14, -14, -14, -15, -15, -15, -16, -16, -17, -18, -18, -19, -20, -21, -22, -23, -24, -26, -27, -28, -30, -31, -33, -34, -36, -38, -40, -42, -44, -46, -48, -51, -53, -55, -58, -61, -63, -66, -69, -72, -75, -79, -82, -86, -89, -93, -97, -100, -104, -108, -113, -117, -122, -126, -131, -136, -141, -146, -151, -156, -162, -167, -173, -179, -185, -191, -197, -204, -210, -217, -224, -231, -238, -246, -253, -261, -269, -277, -285, -293, -301, -310, -319, -328, -337, -346, -356, -366, -375, -385, -396, -406, -417, -427, -438, -449, -461, -472, -484, -495, -507, -520, -532, -545, -557, -570, -583, -597, -610, -624, -638, -652, -666, -680, -695, -709, -724, -739, -755, -770, -786, -801, -817, -833, -850, -866, -883, -899, -916, -933, -950, -968, -985, -1003, -1021, -1038, -1056, -1075, -1093, -1111, -1130, -1148, -1167, -1186, -1204, -1223, -1242, -1262, -1281, -1300, -1319, -1339, -1358, -1378, -1397, -1417, -1436, -1456, -1475, -1495, -1515, -1534, -1554, -1573, -1593, -1612, -1632, -1651, -1670, -1689, -1708, -1727, -1746, -1765, -1784, -1802, -1821, -1839, -1857, -1875, -1893, -1910, -1927, -1945, -1961, -1978, -1994, -2011, -2026, -2042, -2057, -2072, -2087, -2101, -2115, -2129, -2142, -2155, -2167, -2179, -2191, -2202, -2213, -2223, -2233, -2242, -2251, -2259, -2267, -2274, -2280, -2286, -2292, -2297, -2301, -2304, -2307, -2309, -2311, -2312, -2312, -2311, -2310, -2308, -2305, -2302, -2297, -2292, -2286, -2279, -2271, -2262, -2253, -2242, 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
638, -624, -610, -597, -583, -570, -557, -545, -532, -520, -507, -495, -484, -472, -461, -449, -438, -427, -417, -406, -396, -385, -375, -366, -356, -346, -337, -328, -319, -310, -301, -293, -285, -277, -269, -261, -253, -246, -238, -231, -224, -217, -210, -204, -197, -191, -185, -179, -173, -167, -162, -156, -151, -146, -141, -136, -131, -126, -122, -117, -113, -108, -104, -100, -97, -93, -89, -86, -82, -79, -75, -72, -69, -66, -63, -61, -58, -55, -53, -51, -48, -46, -44, -42, -40, -38, -36, -34, -33, -31, -30, -28, -27, -26, -24, -23, -22, -21, -20, -19, -18, -18, -17, -16, -16, -15, -15, -15, -14, -14, -14, -14, -14}; 

#endif /* __FLATTOP_WINDOW_H */
