LCAV/crazyflie-audio/firmware/audio_shield_firmware/Core/Inc/hann_window.h

#ifndef __HANN_WINDOW_H 
#define __HANN_WINDOW_H

int16_t hann_window[1024] = {0, 0, 1, 3, 5, 8, 11, 15, 20, 25, 31, 37, 44, 52, 61, 69, 79, 89, 100, 111, 123, 136, 149, 163, 178, 193, 208, 225, 242, 259, 277, 296, 315, 335, 356, 377, 399, 421, 444, 468, 492, 517, 542, 568, 595, 622, 650, 678, 707, 736, 766, 797, 829, 860, 893, 926, 960, 994, 1029, 1064, 1100, 1136, 1174, 1211, 1250, 1288, 1328, 1368, 1408, 1449, 1491, 1533, 1576, 1619, 1663, 1708, 1753, 1798, 1844, 1891, 1938, 1986, 2034, 2083, 2133, 2182, 2233, 2284, 2335, 2387, 2440, 2493, 2547, 2601, 2655, 2711, 2766, 2823, 2879, 2937, 2994, 3053, 3111, 3170, 3230, 3290, 3351, 3412, 3474, 3536, 3599, 3662, 3726, 3790, 3855, 3920, 3985, 4051, 4118, 4185, 4252, 4320, 4388, 4457, 4526, 4596, 4666, 4737, 4808, 4879, 4951, 5023, 5096, 5169, 5243, 5317, 5391, 5466, 5541, 5617, 5693, 5769, 5846, 5923, 6001, 6079, 6157, 6236, 6315, 6395, 6475, 6555, 6636, 6717, 6798, 6880, 6962, 7045, 7128, 7211, 7294, 7378, 7463, 7547, 7632, 7717, 7803, 7889, 7975, 8061, 8148, 8235, 8323, 8411, 8499, 8587, 8676, 8765, 8854, 8943, 9033, 9123, 9214, 9304, 9395, 9486, 9578, 9669, 9761, 9853, 9946, 10038, 10131, 10224, 10318, 10411, 10505, 10599, 10693, 10788, 10883, 10977, 11073, 11168, 11263, 11359, 11455, 11551, 11647, 11744, 11840, 11937, 12034, 12131, 12228, 12326, 12423, 12521, 12619, 12717, 12815, 12913, 13012, 13110, 13209, 13308, 13407, 13506, 13605, 13704, 13803, 13903, 14002, 14102, 14201, 14301, 14401, 14501, 14601, 14701, 14801, 14901, 15002, 15102, 15202, 15303, 15403, 15503, 15604, 1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
 4320, 4252, 4185, 4118, 4051, 3985, 3920, 3855, 3790, 3726, 3662, 3599, 3536, 3474, 3412, 3351, 3290, 3230, 3170, 3111, 3053, 2994, 2937, 2879, 2823, 2766, 2711, 2655, 2601, 2547, 2493, 2440, 2387, 2335, 2284, 2233, 2182, 2133, 2083, 2034, 1986, 1938, 1891, 1844, 1798, 1753, 1708, 1663, 1619, 1576, 1533, 1491, 1449, 1408, 1368, 1328, 1288, 1250, 1211, 1174, 1136, 1100, 1064, 1029, 994, 960, 926, 893, 860, 829, 797, 766, 736, 707, 678, 650, 622, 595, 568, 542, 517, 492, 468, 444, 421, 399, 377, 356, 335, 315, 296, 277, 259, 242, 225, 208, 193, 178, 163, 149, 136, 123, 111, 100, 89, 79, 69, 61, 52, 44, 37, 31, 25, 20, 15, 11, 8, 5, 3, 1, 0, 0}; 

#endif /* __HANN_WINDOW_H */
