LCAV/crazyflie-audio/firmware/audio_shield_firmware/Core/Inc/tukey_window.h

#ifndef __TUKEY_WINDOW_H 
#define __TUKEY_WINDOW_H

int16_t tukey_window[1024] = {0, 8, 31, 69, 123, 193, 277, 377, 492, 622, 766, 926, 1100, 1288, 1491, 1708, 1938, 2182, 2440, 2711, 2994, 3290, 3599, 3920, 4252, 4596, 4951, 5317, 5693, 6079, 6475, 6880, 7294, 7717, 8148, 8587, 9033, 9486, 9946, 10411, 10883, 11359, 11840, 12326, 12815, 13308, 13803, 14301, 14801, 15303, 15805, 16308, 16811, 17314, 17816, 18316, 18815, 19311, 19805, 20295, 20782, 21264, 21742, 22215, 22682, 23144, 23599, 24047, 24488, 24921, 25347, 25764, 26172, 26570, 26960, 27339, 27708, 28066, 28413, 28749, 29073, 29385, 29685, 29973, 30247, 30509, 30757, 30992, 31212, 31419, 31612, 31790, 31954, 32103, 32238, 32357, 32461, 32550, 32624, 32683, 32726, 32754, 32766, 32767, 32767, 32767, 32767, 32767, 32767, 32767, 32767, 32767, 32767, 32767, 32767, 32767, 32767, 32767, 32767, 32767, 32767, 32767, 32767, 32767, 32767, 32767, 32767, 32767, 32767, 32767, 32767, 32767, 32767, 32767, 32767, 32767, 32767, 32767, 32767, 32767, 32767, 32767, 32767, 32767, 32767, 32767, 32767, 32767, 32767, 32767, 32767, 32767, 32767, 32767, 32767, 32767, 32767, 32767, 32767, 32767, 32767, 32767, 32767, 32767, 32767, 32767, 32767, 32767, 32767, 32767, 32767, 32767, 32767, 32767, 32767, 32767, 32767, 32767, 32767, 32767, 32767, 32767, 32767, 32767, 32767, 32767, 32767, 32767, 32767, 32767, 32767, 32767, 32767, 32767, 32767, 32767, 32767, 32767, 32767, 32767, 32767, 32767, 32767, 32767, 32767, 32767, 32767, 32767, 32767, 32767, 32767, 32767, 32767, 32767, 32767, 32767, 32767, 32767, 3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

#endif /* __TUKEY_WINDOW_H */
