LCAV/crazyflie-audio/firmware/XYTable_210923_Recovery/Core/Src/params.c

/**
  ******************************************************************************
  * @file    params.c
  * @author  IPD SYSTEM LAB & TECH MKTG
  * @version V0.0.1
  * @date    04-June-2015
  * @brief   This file contains the parameters for the used stepper motors.
  ******************************************************************************
  * @attention
  *
  * <h2><center>&copy; COPYRIGHT(c) 2014 STMicroelectronics</center></h2>
  *
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
  ******************************************************************************
  */ 

/* Includes ------------------------------------------------------------------*/
#include "params.h"
#include "xnucleoihm02a1.h"

/**
  * @addtogroup   MotionControl
  * @{
  */

/**
  * @addtogroup MicrosteppingMotor_Example
  * @{
  */

/**
  * @addtogroup Attached_Motor_Parameters
  * @{
  */

/**
  * @addtogroup Parameters_Exported_Constants
  * @{
  */

/**
  * @brief  This array contains the initial parameters for the motors that are
  *         linked with each L6470 mounted on each stacked X-NUCLEO-IHM02A1.
  */
const MotorParameterData_t MotorParameterInitData[EXPBRD_MOUNTED_NR_MAX][L6470DAISYCHAINSIZE] = {
  {
	{9.0, 400, 1.7, 3.06, 300.0, 500.0, 500.0, 400.0, 0.0, 602.7, 3.06, 3.06,\
	  3.06, 3.06, 61.52, 392.1569e-6, 643.1372e-6, 643.1372e-6, 0,\
		3.06*1000*1.10, 3.06*1000*1.00, MICROSTEP_1_128, 0xFF, 0x2E88},
	{9.0, 400, 1.7, 3.06, 300.0, 500.0, 500.0, 400.0, 0.0, 602.7, 3.06, 3.06,\
	  3.06, 3.06, 61.52, 392.1569e-6, 643.1372e-6, 643.1372e-6, 0,\
		3.06*1000*1.10, 3.06*1000*1.00, MICROSTEP_1_128, 0xFF, 0x2E88},
  },
  {
    {9.0, 400, 1.7, 3.06, 300.0, 500.0, 500.0, 400.0, 0.0, 602.7, 3.06, 3.06,\
      3.06, 3.06, 61.52, 392.1569e-6, 643.1372e-6, 643.1372e-6, 0,\
        3.06*1000*1.10, 3.06*1000*1.00, MICROSTEP_1_128, 0xFF, 0x2E88},
    {9.0, 400, 1.7, 3.06, 300.0, 500.0, 500.0, 400.0, 0.0, 602.7, 3.06, 3.06,\
      3.06, 3.06, 61.52, 392.1569e-6, 643.1372e-6, 643.1372e-6, 0,\
        3.06*1000*1.10, 3.06*1000*1.00, MICROSTEP_1_128, 0xFF, 0x2E88},
  },
  {
    {9.0, 400, 1.7, 3.06, 300.0, 500.0, 500.0, 400.0, 0.0, 602.7, 3.06, 3.06,\
      3.06, 3.06, 61.52, 392.1569e-6, 643.1372e-6, 643.1372e-6, 0,\
        3.06*1000*1.10, 3.06*1000*1.00, MICROSTEP_1_128, 0xFF, 0x2E88},
    {9.0, 400, 1.7, 3.06, 300.0, 500.0, 500.0, 400.0, 0.0, 602.7, 3.06, 3.06,\
      3.06, 3.06, 61.52, 392.1569e-6, 643.1372e-6, 643.1372e-6, 0,\
        3.06*1000*1.10, 3.06*1000*1.00, MICROSTEP_1_128, 0xFF, 0x2E88},
  },
  {
    {9.0, 400, 1.7, 3.06, 300.0, 500.0, 500.0, 400.0, 0.0, 602.7, 3.06, 3.06,\
      3.06, 3.06, 61.52, 392.1569e-6, 643.1372e-6, 643.1372e-6, 0,\
        3.06*1000*1.10, 3.06*1000*1.00, MICROSTEP_1_128, 0xFF, 0x2E88},
    {9.0, 400, 1.7, 3.06, 300.0, 500.0, 500.0, 400.0, 0.0, 602.7, 3.06, 3.06,\
      3.06, 3.06, 61.52, 392.1569e-6, 643.1372e-6, 643.1372e-6, 0,\
        3.06*1000*1.10, 3.06*1000*1.00, MICROSTEP_1_128, 0xFF, 0x2E88},
  },
};
  
/**
  * @}
  */    /* Parameters_Exported_Constants */

/**
  * @addtogroup Parameters_Exported_Functions
  * @{
  */

/**
  * @brief  Return the initial motor parameters.
  * @param  index   The index inside the array of parameters to point the right data.
  * @retval MotorParameterData_t*   The pointer to the data structure of parameters.
  */
MotorParameterData_t *GetMotorParameterInitData(void)
{
  return (MotorParameterData_t*)(MotorParameterInitData);
}

/**
  * @}
  */    /* Parameters_Exported_Functions */
  
/**
  * @}
  */ /* End of Attached_Motor_Parameters */

/**
  * @}
  */ /* End of MicrosteppingMotor_Example */

/**
  * @}
  */ /* End of MotionControl */

/************************ (C) COPYRIGHT STMicroelectronics *****END OF FILE****/
