LCAV/crazyflie-audio/firmware/XYTable_210923_Recovery/Core/Src/example.c

/**
  ******************************************************************************
  * @file       example.c
  * @date       01/10/2014 12:00:00
  * @brief      Example functions for the X-NUCLEO-IHM02A1
******************************************************************************
  *
  * COPYRIGHT(c) 2014 STMicroelectronics
  *
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
  ******************************************************************************
  */

#include "example.h"
#include "example_usart.h"
#include "params.h"
#include "xnucleoihm02a1.h"

/**
  * @addtogroup MicrosteppingMotor_Example
  * @{
  */

/**
  * @addtogroup Example
  * @{
  */

/**
  * @defgroup   ExamplePrivateFunctions
  * @brief      Example Private Functions.
  * @{
  */

uint16_t BSP_ST1S14_PGOOD(void);
uint32_t pow(uint8_t base, uint8_t exponent);

/**
  * @}
  */ /* End of ExamplePrivateFunctions */

/**
  * @addtogroup ExamplePrivateFunctions
  * @brief      Example Private Functions.
  * @{
  */

/**
  * @addtogroup ExampleExportedFunctions
  * @brief      Example Exported Functions.
  * @{
  */

/**
  * @brief  Example no.1 for X-NUCLEO-IHM02A1.
  * @note	Perform a complete motor axis revolution as MPR_1 equal movements,
  *			for each L6470 mounted on all stacked X-NUCLEO-IHM02A1.
  *			At the end of each movement there is a delay of DELAY_1 ms.
  *     	After each motor has performed a complete revolution there is a
  *			delay of DELAY_2 ms.
  *			Now all motors for each X-NUCLEO-IHM02A1 will start at the same
  *			time.
  *			They are going to run at INIT_SPEED for DELAY_3 ms.
  *			After that all motors for each X-NUCLEO-IHM02A1 will get a HardStop
  *			at the same time.
  *			Perform a complete motor axis revolution as MPR_2 equal movements,
  *			for each L6470 mounted on all stacked X-NUCLEO-IHM02A1.
  *			At the end of each movement there is a delay of DELAY_1 ms.
  *			After that all motors for each X-NUCLEO-IHM02A1 will get a HardHiZ
  *			at the same time.
  */
void MicrosteppingMotor_Example_01(void)
{
#define MPR_1     4			  //!< Motor Movements Per Revolution 1st option
#define MPR_2     8			  //!< Motor Movements Per Revolution 2nd option
#define DELAY_1   1000		//!< Delay time 1st option
#define DELAY_2   2500		//!< Delay time 2nd option
#define DELAY_3   10000   //!< Delay time 3rd option
  
  uint32_t Step;
  uint32_t Speed;
  uint8_t MovementPerRevolution;
  uint8_t i;
  uint8_t board, device;
  
  uint8_t id;
  
  StepperMotorBoardHandle_t *StepperMotorBoardHandle;
  MotorParameterData_t *MotorParameterDataGlobal, *MotorParameterDataSingle;
  
  #ifdef NUCLEO_USE_USART
  USART_Transmit(&huart2, "Initial values for registers:\n\r");
  USART_PrintAllRegisterValues();
  #endif

  /* Setup each X-NUCLEO-IHM02A1 Expansion Board ******************************/
  
  /* Get the parameters for the motor connected with the 1st stepper motor driver of the 1st stepper motor expansion board */
  MotorParameterDataGlobal = GetMotorParameterInitData();
  
  for (id = 0; id < EXPBRD_MOUNTED_NR; id++)
  {
    StepperMotorBoardHandle = BSP_GetExpansionBoardHandle(EXPBRD_ID(id));
    MotorParameterDataSingle = MotorParameterDataGlobal+(id*L6470DAISYCHAINSIZE);
    StepperMotorBoardHandle->Config(MotorParameterDataSingle);
  }
  
  #ifdef NUCLEO_USE_USART
  USART_Transmit(&huart2, "Custom values for registers:\n\r");
  USART_PrintAllRegisterValues();
  #endif
  
  /****************************************************************************/
  
  MovementPerRevolution = MPR_1;
  for (board = EXPBRD_ID(0); board <= EXPBRD_ID(EXPBRD_MOUNTED_NR-1); board++)
  {
    StepperMotorBoardHandle = BSP_GetExpansionBoardHandle(board);
    
    for (device = L6470_ID(0); device <= L6470_ID(L6470DAISYCHAINSIZE-1); device++)
    {
      /* Get the parameters for the motor connected with the actual stepper motor driver of the actual stepper motor expansion board */
      MotorParameterDataSingle = MotorParameterDataGlobal+((board*L6470DAISYCHAINSIZE)+device);
      Step = ((uint32_t)MotorParameterDataSingle->fullstepsperrevolution * pow(2, MotorParameterDataSingle->step_sel)) / MovementPerRevolution;
      
      for (i=0; i<MovementPerRevolution; i++)
      {
        StepperMotorBoardHandle->Command->Move(board, device, L6470_DIR_FWD_ID, Step);
        while(StepperMotorBoardHandle->Command->CheckStatusRegisterFlag(board, device, BUSY_ID) == 0);
        HAL_Delay(DELAY_1);
      }
    }
  }
  
  HAL_Delay(DELAY_2);
  
  for (board = EXPBRD_ID(0); board <= EXPBRD_ID(EXPBRD_MOUNTED_NR-1); board++)
  {
    
    for (device = L6470_ID(0); device <= L6470_ID(L6470DAISYCHAINSIZE-1); device++)
    {
      /* Get the parameters for the motor connected with the actual stepper motor driver of the actual stepper motor expansion board */
      MotorParameterDataSingle = MotorParameterDataGlobal+((board*L6470DAISYCHAINSIZE)+device);
      
      /* Set Speed */
      Speed = Step_s_2_Speed(MotorParameterDataSingle->speed);
      
      /* Prepare the stepper driver to be ready to perform a command */
      StepperMotorBoardHandle->StepperMotorDriverHandle[device]->Command->PrepareRun(device, L6470_DIR_FWD_ID, Speed);
    }
    
    StepperMotorBoardHandle->Command->PerformPreparedApplicationCommand();
  }
  
  HAL_Delay(DELAY_3);

  for (board = EXPBRD_ID(0); board <= EXPBRD_ID(EXPBRD_MOUNTED_NR-1); board++)
  {
    
    for (device = L6470_ID(0); device <= L6470_ID(L6470DAISYCHAINSIZE-1); device++)
    {
      /* Prepare the stepper driver to be ready to perform a command */
      StepperMotorBoardHandle->StepperMotorDriverHandle[device]->Command->PrepareHardStop(device);
    }
    
    StepperMotorBoardHandle->Command->PerformPreparedApplicationCommand();
  }

  MovementPerRevolution = MPR_2;
  for (board = EXPBRD_ID(0); board <= EXPBRD_ID(EXPBRD_MOUNTED_NR-1); board++)
  {
    StepperMotorBoardHandle = BSP_GetExpansionBoardHandle(board);
    
    for (device = L6470_ID(0); device <= L6470_ID(L6470DAISYCHAINSIZE-1); device++)
    {
      /* Get the parameters for the motor connected with the actual stepper motor driver of the actual stepper motor expansion board */
      MotorParameterDataSingle = MotorParameterDataGlobal+((board*L6470DAISYCHAINSIZE)+device);
      Step = ((uint32_t)MotorParameterDataSingle->fullstepsperrevolution * pow(2, MotorParameterDataSingle->step_sel)) / MovementPerRevolution;
      
      for (i=0; i<MovementPerRevolution; i++)
      {
        StepperMotorBoardHandle->Command->Move(board, device, L6470_DIR_FWD_ID, Step);
        while(StepperMotorBoardHandle->Command->CheckStatusRegisterFlag(board, device, BUSY_ID) == 0);
        HAL_Delay(DELAY_1);
      }
    }
  }
  
  for (board = EXPBRD_ID(0); board <= EXPBRD_ID(EXPBRD_MOUNTED_NR-1); board++)
  {
    
    for (device = L6470_ID(0); device <= L6470_ID(L6470DAISYCHAINSIZE-1); device++)
    {
      /* Prepare the stepper driver to be ready to perform a command */
      StepperMotorBoardHandle->StepperMotorDriverHandle[device]->Command->PrepareHardHiZ(device);
    }
    
    StepperMotorBoardHandle->Command->PerformPreparedApplicationCommand();
  }
  
  /* Switch on the user LED */
    BSP_LED_On(LED2);
}

/**
  * @}
  */ /* End of ExampleExportedFunctions */

/**
  * @brief  This function return the ADC conversion result about the ST1S14 PGOOD.
  * @retval PGOOD The number into the range [0, 4095] as [0, 3.3]V.
  * @note   It will just return 0 if USE_ST1S14_PGOOD is not defined.
  */
uint16_t BSP_ST1S14_PGOOD(void)
{
#ifdef USE_ST1S14_PGOOD
  HAL_ADC_Start(&HADC);
  HAL_ADC_PollForConversion(&HADC, 100);
  
  return HAL_ADC_GetValue(&HADC);
#else
  return 0;
#endif
}

/**
  * @brief  Calculates the power of a number.
  * @param  base      the base
  * @param  exponent  the exponent
  * @retval power     the result as (base^exponent)
  * @note   There is not OVF control.
  */
uint32_t pow(uint8_t base, uint8_t exponent)
{
  uint8_t i;
  uint32_t power = 1;
  
  for (i=0; i<exponent; i++)
    power *= base;
  
  return power;
}

/**
  * @brief  EXTI line detection callbacks.
  * @param  GPIO_Pin: Specifies the port pin connected to corresponding EXTI line.
  * @retval None
  */
void HAL_GPIO_EXTI_Callback(uint16_t GPIO_Pin)
{
  switch (GPIO_Pin)
  {
  case GPIO_PIN_13:
    BSP_EmergencyStop();
    break;
  case L6470_nBUSY_SYNC_GPIO_PIN:
    BSP_L6470_BusySynchEventManager();
    break;
  case L6470_nFLAG_GPIO_PIN:
    BSP_L6470_FlagEventManager();
    break;
  }
}

/**
  * @}
  */ /* End of ExamplePrivateFunctions */

/**
  * @}
  */ /* End of Example */

/**
  * @}
  */ /* End of MicrosteppingMotor_Example */

/************************ (C) COPYRIGHT STMicroelectronics *****END OF FILE****/
