LCAV/crazyflie-audio/firmware/audio_shield_firmware/Core/Inc/simulated_data_1024.h

float32_t mk2[1024] = {-1.004471285647860, -0.975443263547083, -0.947021599877245, -0.885070738955996, -0.819966112832356, -0.705412956855961, -0.580379687781510, -0.463527505757628, -0.311679179434984, -0.156108319573297, -0.013731173202466, 0.159586058960656, 0.317478600850797, 0.445395340331227, 0.591290712079115, 0.693983947074175, 0.808630039282286, 0.874848800641335, 0.962270693377510, 0.991777345974506, 0.999753830441242, 0.979936724403446, 0.963794075596741, 0.910677541680916, 0.790437175730480, 0.719468421491076, 0.604061759823961, 0.457370616705290, 0.297024314051596, 0.165067918215671, -0.001809203020782, -0.162473671318165, -0.321317575731620, -0.448485124779785, -0.579857183633280, -0.713342088483347, -0.803811231004215, -0.902449938084599, -0.943037905976440, -0.987222667610896, -1.001865697719073, -0.988705799320429, -0.942367654725095, -0.883502407789717, -0.803722341131419, -0.705729769086574, -0.587007041013348, -0.447806697119563, -0.306692048783161, -0.149608950971586, -0.003101167735180, 0.132086087399158, 0.319405240393541, 0.475860296209289, 0.592198896728160, 0.706105228853714, 0.807652546935987, 0.889815982310620, 0.951230610378154, 0.976468153307669, 0.994829055420798, 0.977718072318635, 0.953544507909031, 0.888040112664659, 0.813969107614726, 0.705359749589123, 0.597648604170685, 0.456125838752900, 0.330923991664642, 0.137470855811317, -0.006469166882550, -0.147419596123745, -0.283733737306886, -0.456476847516704, -0.587348562360693, -0.709369923611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
