LCAV/crazyflie-audio/firmware/audio_shield_firmware/Core/Inc/simulated_data_32.h

float32_t mk2[32] = {-0.711578066834407, -0.666555668484887, -0.645413131912275, -0.613158164077463, -0.598734370749883, -0.553876408689015, -0.515093000204986, -0.498158247515035, -0.456652684799583, -0.418333592070494, -0.396414605567557, -0.342965463157070, -0.300555387899097, -0.280035609273394, -0.229939904069264, -0.208213156128502, -0.156821420132892, -0.133695121004871, -0.067244918645488, -0.035170810379700, -0.000246169558758, 0.031508199567377, 0.091196655029433, 0.137208414950385, 0.137854646395763, 0.207451962320657, 0.249721871387395, 0.274820566830819, 0.297024314051595, 0.354750510252933, 0.380874229344308, 0.412620531259496}; 

float32_t mk1[32] = {-0.785267653276632, -0.734932231835659, -0.724936021527441, -0.704855107211859, -0.673878641250399, -0.658861830293923, -0.609735054759717, -0.583209491577580, -0.544160164939564, -0.530411620590461, -0.499143607797130, -0.465790578866818, -0.418704099346456, -0.386137712447466, -0.325698697236494, -0.302238866045927, -0.234901948392720, -0.232793484100267, -0.189388871725768, -0.160613671441666, -0.130468026811407, -0.077527623731606, -0.034617797596883, 0.013788579103014, 0.022583905568766, 0.082516965571250, 0.118759878013187, 0.160438355806795, 0.185705457767368, 0.240591058045395, 0.286251626758194, 0.305419004449633}; 

float32_t mk4[32] = {-0.864080637163375, -0.845981141053660, -0.798837021135731, -0.784182860217023, -0.760058169747273, -0.763597193090722, -0.679623595546483, -0.667754104356770, -0.643614166226441, -0.605408834197476, -0.600399240025578, -0.570068584322617, -0.520526025010999, -0.473075329020542, -0.450045668269322, -0.410847906505558, -0.381910283631408, -0.334194825010513, -0.300701758914102, -0.278853755254773, -0.221953672771591, -0.193708355639737, -0.123769742743116, -0.126188002738268, -0.081918561315408, -0.040891694227894, 0.002133484869213, 0.041183213226549, 0.089176352360964, 0.151378262269065, 0.149691700323897, 0.214848004086728}; 

float32_t mk3[32] = {-0.911277074641484, -0.875542585643521, -0.869834170006543, -0.864532272476556, -0.818820243122279, -0.812793556504041, -0.767398039689135, -0.761899403597157, -0.721302888020269, -0.689005633165830, -0.670893270791083, -0.663211408187734, -0.611590128321925, -0.589441672312766, -0.542224585439147, -0.499499310243295, -0.473933669225445, -0.451195942833812, -0.422961058374841, -0.375897492940129, -0.332345318376967, -0.296764631588466, -0.250574751142247, -0.238678599771007, -0.180806966477955, -0.140609401393022, -0.112568412806209, -0.068168700787338, -0.019019733106552, 0.005927401963433, 0.035985083892914, 0.081030558054066}; 
