LCAV/crazyflie-audio/(commit log)

2020-07-27 Add complete material.
    [BOM_audio_shield_1.csv, BOM_audio_shield_2.csv, BOM_audio_shield_6.csv, BOM_audio_shield_7.csv, SPH0645LM4H-B .sch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]
2020-07-29 Update PCB info after footprint missmatch
    [audio_shield.sch, holding_headers.sch]
2020-07-29 edit .ioc and corresponding c files to adapt to the pcb pinout
2020-08-07 added documentation for PID tuning
2020-08-14 fix pinout issue on stm32
    [audio_shield_firmware.ioc, main.c, main.h]
2020-08-18 added I2C configuration
2020-08-18 change buffer size and fix gitignore
    [main.c]
2020-08-18 added I2C communication
2020-08-18 fix R and I indexes
    [main.c]
2020-08-18 Fix print
2020-08-19 added thrust while sending packets
2020-08-19 flipped and changed audio deck crazyflie pins + added identification EEPROM
    [SPH0645LM4H-B .sch, audio_shield.kicad_pcb, audio_shield.sch]
2020-08-19 annotation added
    [audio_shield.sch]
2020-08-19 added comment
    [audio_shield.sch]
2020-08-19 Edit component attribute for eurocircuit manufacturing
    [SPH0645LM4H-B .sch, audio_shield.kicad_pcb, audio_shield.sch, stm32f446re.sch]
2020-08-20 Revert "not shure what I do"
    This reverts commit 37857eb5b53a0fb98869ec0b4d1d0d15ce312f00, reversing
    changes made to 0b65fa19d0ccbf03451c7e7100d005444b2b7b70.
    [audio_shield.kicad_pcb, audio_shield.sch]
2020-08-20 Revert "Revert "not shure what I do""
    This reverts commit c38e20f0cd3f4d4c62a5fd8c8ef8a2b8178c72d3.
    [audio_shield.kicad_pcb, audio_shield.sch]
2020-08-20 reset PCB file to 83b76c623
    [audio_shield.kicad_pcb]
2020-08-25 fix uniform bin selection, still miss some bin but they are correctly placed now, tbc
    [bin_selection_research.py]
2020-08-25 added thrust receive function to the audio deck firmware
2020-08-27 fixed bin selection python
    [bin_selection_research.py]
2020-08-27 fix semaphore for audio samples
    [main.c]
2020-08-27 added function to receive I2C parameters
2020-08-27 Remove motor param function prototype
2020-08-31 Receive frequency bins through CRTP (#2)
    * Add frequency bin reading (needs testing)
    * Fix small typos
    * Fix channel reading
    * fixed ? crtp reader
    * small fix
    * Refactor CRTP reading
    * Improve printing
    [reader_crtp.py]
2020-09-01 fix bin selection and embded implementation
    [audio_shield_firmware.ioc, bin_selection_research.py, main.c]
2020-09-01 Correct frequency selection sending and general cleaning
    [audio_shield_firmware.ioc, main.c]
2020-09-04 Added hardfault debugging code, tried different DMA priorities
2020-09-10 Working (slow) spi version
2020-09-10 Add timers and fault checks
2020-09-10 Remove global SPI interrupt
2020-09-11 Change data communication flow, first atempt
2020-09-14 Debugging version of SPI
2020-09-14 Add fixed checksum on audio deck
    [main.c]
2020-09-16 Remove unused and fix indentation
    [main.c]
2020-09-17 Add motor do doc, and rx_synch reset
    [main.c]
2020-09-30 Correct frequency selection and change averaging method
    [main.c]
2020-09-30 Implement motor thrust averaging
2020-10-20 add fabrication files for eurocircuit
    [BOM.xlsx, SPH0645LM4H-B .sch, audio_shield.csv, audio_shield.kicad_pcb, audio_shield.sch, audio_shield_2.csv, holding_headers.sch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]
2020-10-20 Fix motor powrt issue
    [main.c]
2020-10-20 fix timestamp before fft
    [main.c]
2020-10-23 Reset to experiment version
    [main.c]
2020-10-26 Try to stabilize communicaition.. still not fine
    [audio_shield_firmware.ioc, main.c, main.h]
2020-10-28 Switch to DMA
2020-10-28 Switch to non-DEBUG mode
2020-11-02 Fix tapering window and remove unnecessary cubemx params
    [audio_shield_firmware.ioc, main.c, main.h]
2020-11-03 Add sweep and fix loudness calculation
    [play_and_record.py, signals.py]
2020-11-05 Change mic order to match naming on pcb
2020-11-11 Convert Warning to print
2020-11-13 Do not reset selected_indices to zero
    [main.c, play_and_record.py]
2020-11-17 edit gitignore to hide info-cache file of kicad
2020-11-17 Add yaw rate reading
2020-11-19 add rotating table firmware
    [XYTable_19_04_18 Debug.cfg]
2020-11-20 Create serial motors class, finalize chirp
2020-11-23 Add battery check and verbose flag
2020-11-26 add stepper firmware and change motor and parameters
    [XYTable_19_04_18 Debug.cfg]
2020-11-26 Fix serial motors
2020-11-27 Add battery static variable
2020-12-01 Add motors reading
2020-12-04 Add 50cm commands, lower battery-ok-voltage
2020-12-04 change microstepping and add 50cm distance + comments
2020-12-07 Lower battery check
2020-12-09 Adjust battery level
2020-12-11 Lower battery ok level
2020-12-18 Add buzzer frequency index to parameters
    [main.c]
2020-12-18 Adjust velocity
2021-02-11 Reset bin selection, enhance serial motors
    [bin_selection.py, main.c, serial_motors.py]
2021-02-19 Correct max int values
    [main.c]
2021-04-09 implement driver pwm into audio-deck firmware
    [pwm_tuning_control.xlsx]
2021-04-09 add hardware V3
    [SPH0645LM4H-B .sch, audio_shield.csv, audio_shield.kicad_pcb, audio_shield.sch, audio_shield_2.csv, holding_headers.sch, leds.sch, stm32f446re.sch]
2021-04-09 fix issues with big refactoring
    [main.c]
2021-04-19 Update drivers
2021-04-21 Improve pwm tuning script
2021-04-22 Add LED welcome and basic mic response
2021-04-22 Green LED stops when no spi since more than 3s
2021-04-22 Fix buzzer timer
2021-04-23 Debugging SPI
2021-04-30 Update hardware V3 with correct version
    [SPH0645LM4H-B .sch, audio_shield.kicad_pcb, audio_shield.sch, audio_shield_bom.csv, audio_shield_bom2.csv, audio_shield_bom3.csv, leds.sch, stm32f446re.sch]
2021-04-30 Correct PCB after testing the HW
    [audio_shield.kicad_pcb, audio_shield.sch]
2021-06-03 Switch LED on at startup
2021-06-08 Integrate the external buzzer mode hardcoded
    [main.c, sound.h]
2021-06-08 Add Buzzer_idx == 5 for external source
    [main.c]
2021-06-17 Start fixing snr selection
    [main.c, sound.h]
2021-06-17 Fix state machine, working
    [main.c]
2021-06-17 working version with interrupt (pipeline not tested)
2021-06-17 Reactivate spi synchronisation
2021-06-19 Implement windowing around current frequency
2021-06-22 Rename filter_snr_enable
2021-07-08 Fast version with sample to process > 1 ( and fix synch)
    [main.c]
2021-09-28 fix typo for rotation commands
    [serial_motors.py]
2021-09-30 fix issue for measuring with external source
    [main.c, sound.h]
2021-09-30 Add 30 degrees command to serial motors
2021-10-04 Improve naming and fix size
    [main.c]
2021-10-05 Fix mic names, regenerate code
    [audio_shield_firmware.ioc, main.c, real_data_1024.h, real_data_32.h, simulated_data_1024.h, simulated_data_32.h]
2021-10-05 Fix all issues whoowhoo
    [audio_shield_firmware.ioc, main.c]
2021-10-13 Added todo notes for things to be fixed
    [serial_motors.py]
2021-10-14 FIX AND TEST DISTANCE/ANGLE
    [example_usart.c]
