LCAV/crazyflie-audio/(notices)

Notices in the files:
firmware/audio_shield_firmware/Core/Src/main.c:
© Copyright (c) 2020 STMicroelectronics.
All rights reserved.
This software component is licensed by ST under BSD 3-Clause license,
the "License"; You may not use this file except in compliance with the
License. You may obtain a copy of the License at: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
firmware/audio_shield_firmware/Core/Src/led.c:
This program is free software: you can redistribute it and/or modify
it under the terms of the GNU General Public License as published by
the Free Software Foundation, in version 3.
